MatthieuGrr/alidade_ros2/alidade_description/meshes/camera_adaptor.stl

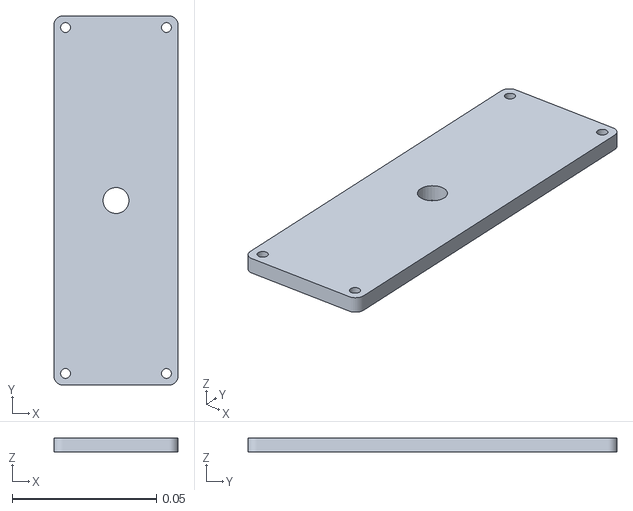
[picture p1: CAD file, 2026-10-08]
alidade_description/meshes/camera_adaptor.stl
0.043 x 0.128 x 0.005
