MatthieuGrr/alidade_ros2/alidade_description/meshes/motor_driver_left_link.stl

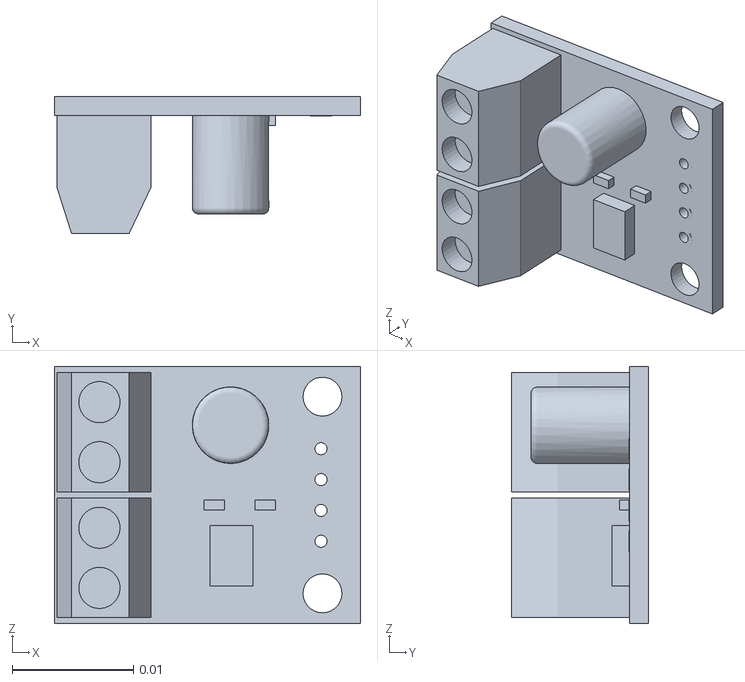
[picture p2: CAD file, 2026-09-28]
alidade_description/meshes/motor_driver_left_link.stl
0.0252 x 0.0113 x 0.0212
