MatthieuGrr/alidade_ros2/alidade_description/meshes/motor_mount_left_link.stl

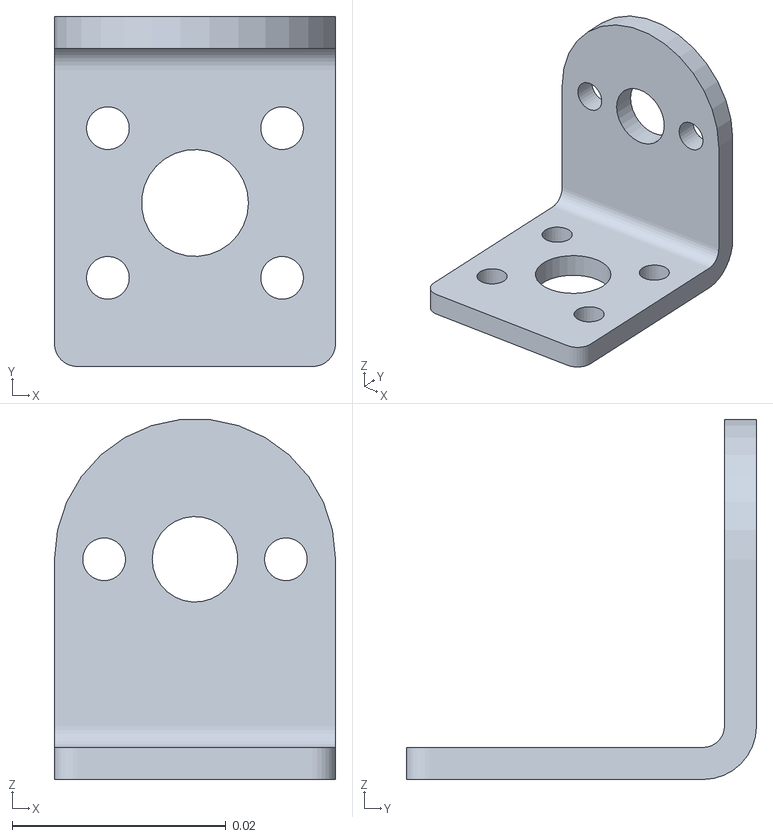
[picture p3: CAD file, 2026-09-28]
alidade_description/meshes/motor_mount_left_link.stl
0.0263 x 0.0327 x 0.0337
