MatthieuGrr/alidade_ros2/alidade_description/meshes/power_bracket_link.stl

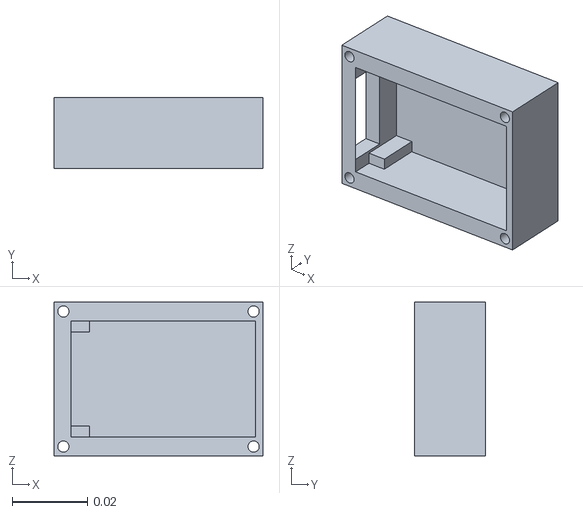
[picture p4: CAD file, 2026-09-28]
alidade_description/meshes/power_bracket_link.stl
0.0557 x 0.019 x 0.041
