MatthieuGrr/alidade_ros2/alidade_description/meshes/wheel_right_link.stl

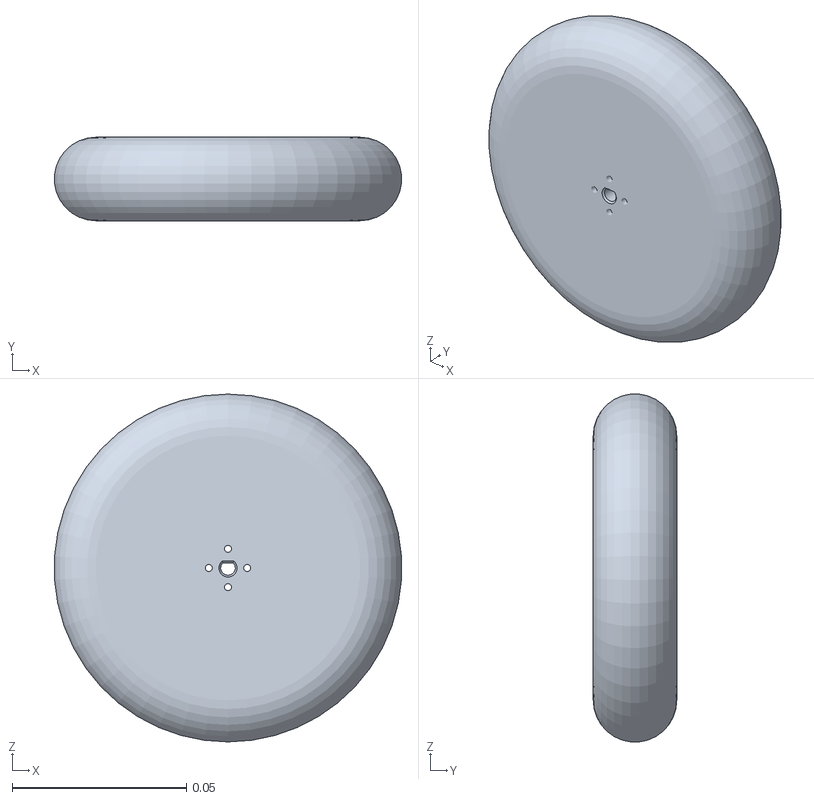
[picture p5: CAD file, 2026-09-28]
alidade_description/meshes/wheel_right_link.stl
0.0996 x 0.024 x 0.0999
