MatthieuGrr/alidade_ros2/alidade_description/meshes/motor_right_link.stl

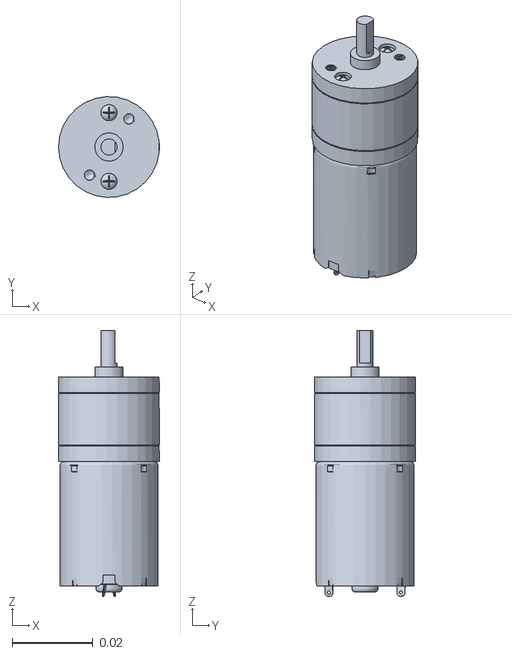
[picture p6: CAD file, 2026-09-28]
alidade_description/meshes/motor_right_link.stl
0.025 x 0.025 x 0.0659
