MatthieuGrr/alidade_ros2/alidade_description/meshes/laser.stl

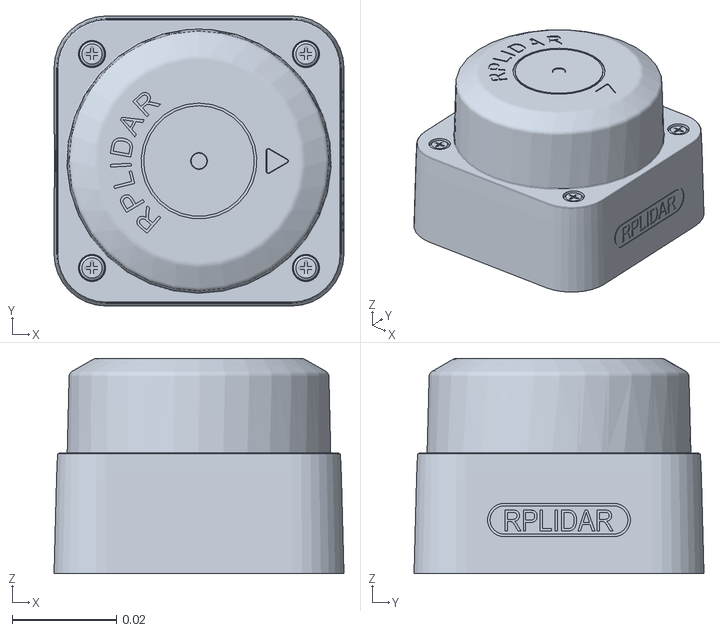
[picture p7: CAD file, 2026-09-28]
alidade_description/meshes/laser.stl
0.0556 x 0.0556 x 0.0413
