MatthieuGrr/alidade_ros2/alidade_description/meshes/base_link.stl

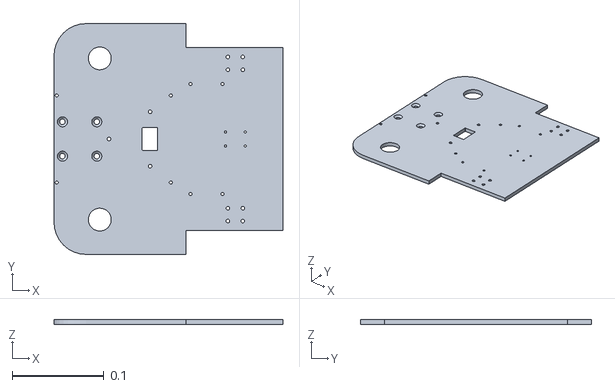
[picture p8: CAD file, 2026-09-28]
alidade_description/meshes/base_link.stl
0.25 x 0.252 x 0.005
