MatthieuGrr/alidade_ros2/alidade_description/meshes/deck_link.stl

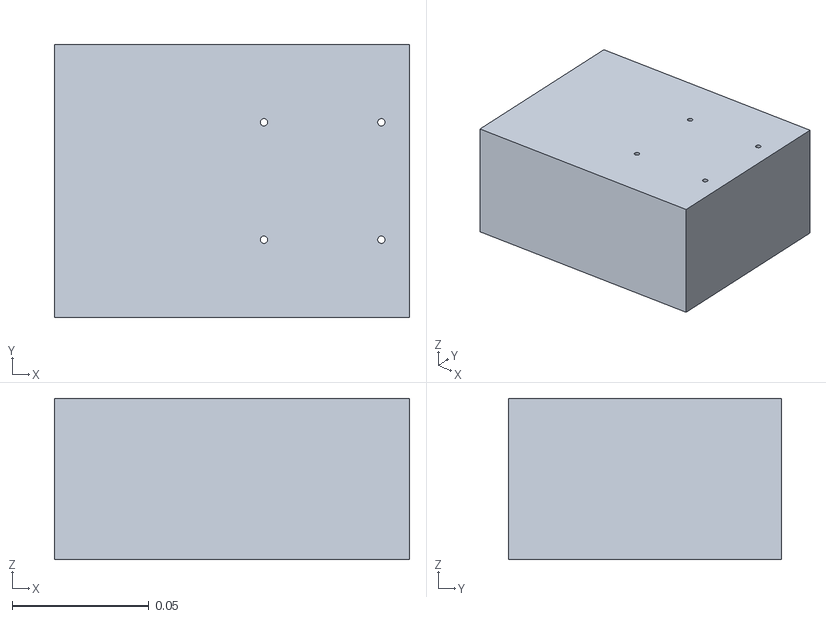
[picture p9: CAD file, 2026-09-28]
alidade_description/meshes/deck_link.stl
0.13 x 0.1 x 0.059
