MatthieuGrr/alidade_ros2/alidade_description/meshes/pi_link.stl

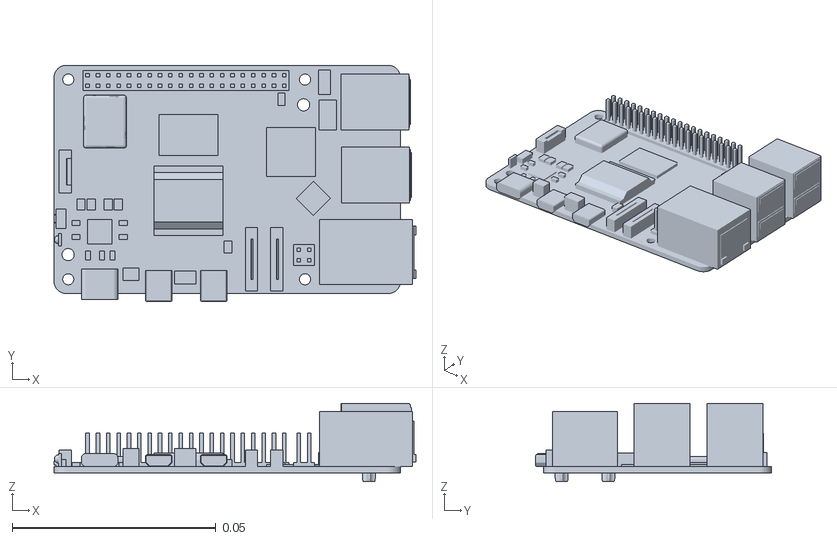
[picture p10: CAD file, 2026-09-28]
alidade_description/meshes/pi_link.stl
0.0888 x 0.058 x 0.0192
