MatthieuGrr/alidade_ros2/alidade_description/meshes/camera_mount_link.stl

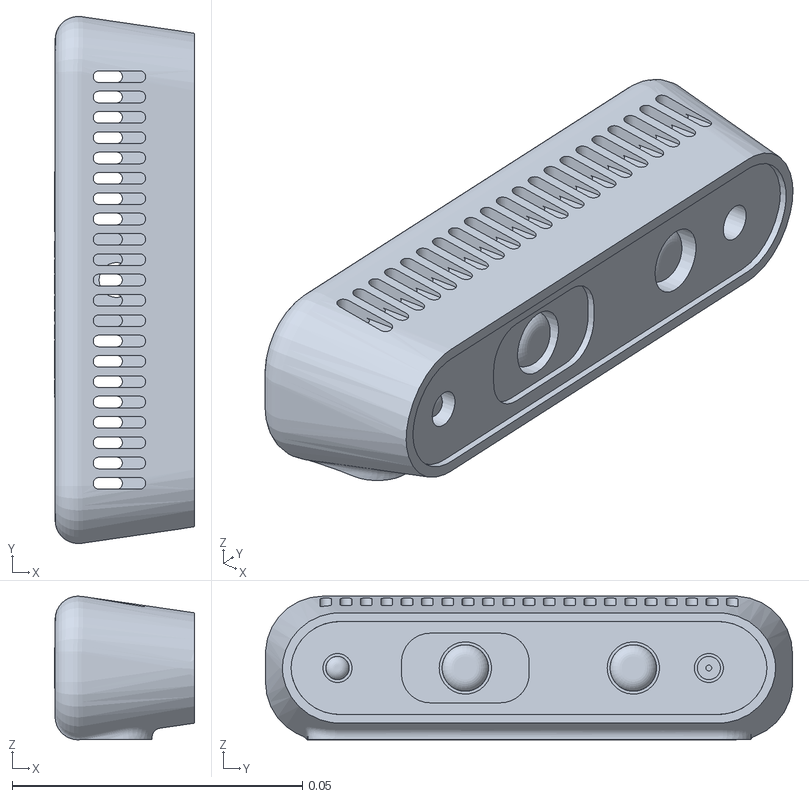
[picture p11: CAD file, 2026-09-28]
alidade_description/meshes/camera_mount_link.stl
0.0241 x 0.0907 x 0.0247
