MatthieuGrr/alidade_ros2/alidade_description/meshes/imu_link.stl

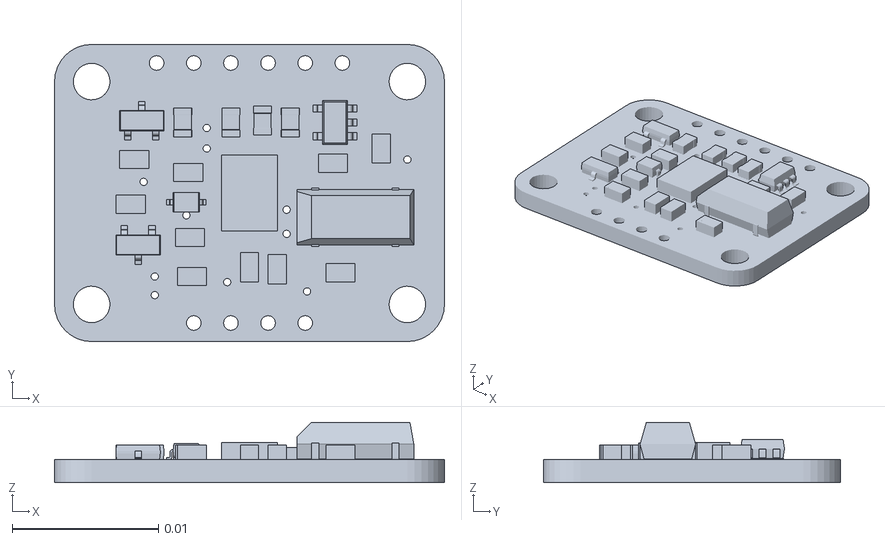
[picture p12: CAD file, 2026-09-28]
alidade_description/meshes/imu_link.stl
0.0267 x 0.0203 x 0.00413
