MatthieuGrr/alidade_ros2/alidade_description/meshes/driver_board_link.stl

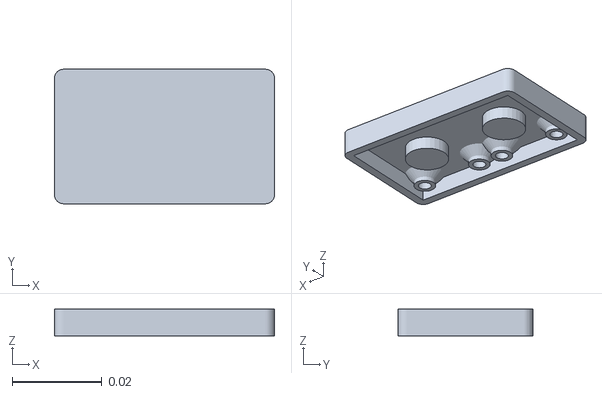
[picture p13: CAD file, 2026-09-28]
alidade_description/meshes/driver_board_link.stl
0.0491 x 0.03 x 0.006
