MatthieuGrr/alidade_ros2/alidade_description/meshes/pi_mount_link.stl

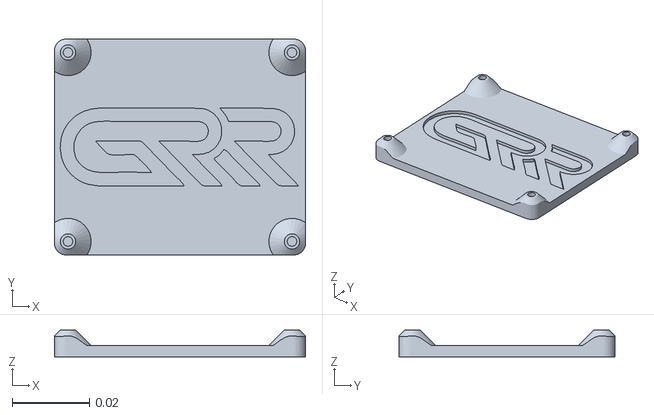
[picture p14: CAD file, 2026-09-28]
alidade_description/meshes/pi_mount_link.stl
0.0651 x 0.056 x 0.007
