MatthieuGrr/alidade_ros2/alidade_description/meshes/battery_tray_link.stl

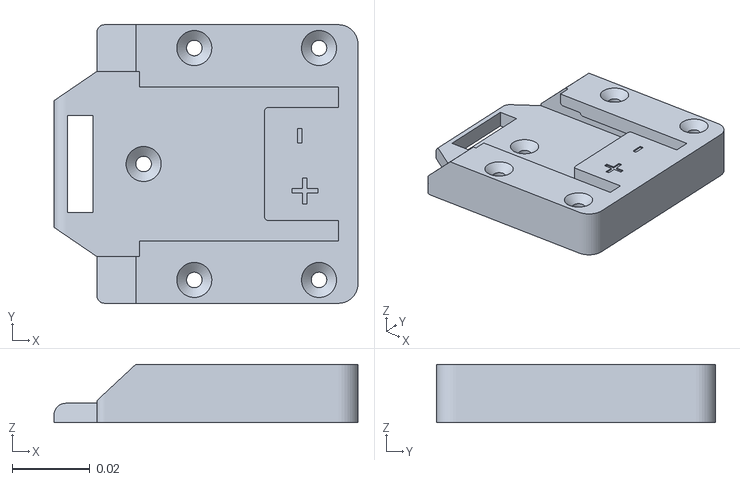
[picture p15: CAD file, 2026-09-28]
alidade_description/meshes/battery_tray_link.stl
0.078 x 0.0715 x 0.015
