MatthieuGrr/alidade_ros2/alidade_description/meshes/caster_wheel_link.stl

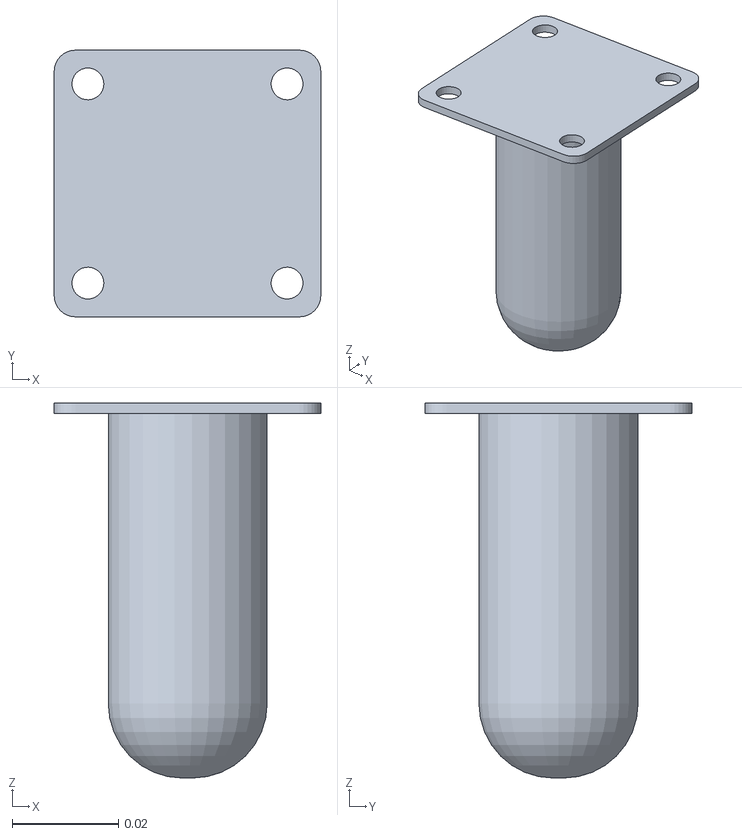
[picture p16: CAD file, 2026-09-28]
alidade_description/meshes/caster_wheel_link.stl
0.0502 x 0.0502 x 0.0706
