MatthieuGrr/alidade_ros2/alidade_description/meshes/dcdc_link.stl

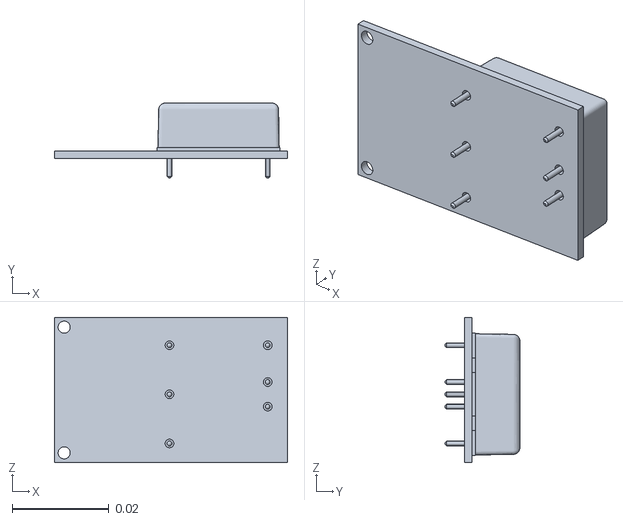
[picture p17: CAD file, 2026-09-28]
alidade_description/meshes/dcdc_link.stl
0.0482 x 0.0155 x 0.03
