MatthieuGrr/alidade_ros2/alidade_description/meshes/battery_link.stl

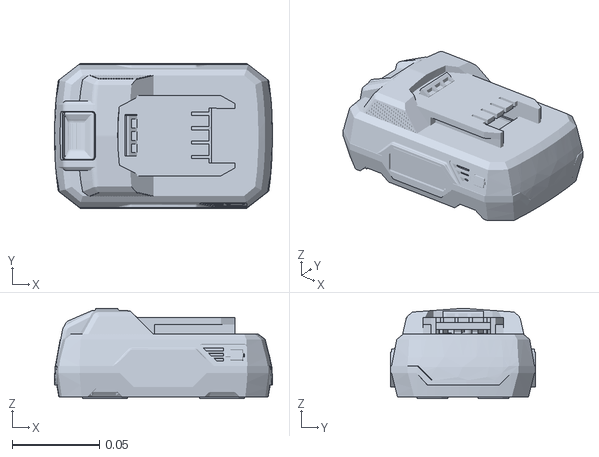
[picture p18: CAD file, 2026-09-28]
alidade_description/meshes/battery_link.stl
0.125 x 0.0828 x 0.0518
