MatthieuGrr/alidade_ros2/(list of files, cad)

Other CAD files:
alidade_description/meshes/motor_driver_right_link.stl
alidade_description/meshes/wheel_left_link.stl
alidade_description/meshes/motor_mount_right_link.stl
alidade_description/meshes/motor_left_link.stl
