MatthieuGrr/alidade_ros2/alidade_description/urdf/onshape/alidade_v2.urdf

<!--URDF generated by ONSHAPE BY PTC INC, 1.221-->
<robot name="alidade_v2">
    <link name="base_link">
        <inertial>
            <mass value="0.000275747" />
            <origin xyz="-0.129402 5.40301e-18 0.00249813" rpy="0 -0 0" />
            <inertia ixx="1.23398e-06" ixy="0" ixz="-4.77266e-11" iyy="1.3884e-06" iyz="0" izz="2.62123e-06" />
        </inertial>
        <visual>
            <origin xyz="-0.125 6.93889e-18 0" rpy="0 -0 0" />
            <geometry>
                <mesh filename="package://alidade_v2/meshes/base_link.stl" scale="1 1 1" />
            </geometry>
            <material name="0.615686_0.811765_0.929412_0.000000_0.000000">
                <color rgba="0.615686 0.811765 0.929412 1" />
            </material>
        </visual>
    </link>
    <link name="battery_link">
        <inertial>
            <mass value="0.000122132" />
            <origin xyz="-0.00630539 0.000320142 -0.0239702" rpy="0 -0 0" />
            <inertia ixx="1.07262e-07" ixy="-8.34136e-10" ixz="6.80454e-09" iyy="1.97665e-07" iyz="-8.1505e-10" izz="2.44575e-07" />
        </inertial>
        <visual>
            <origin xyz="0.120887 -0.125114 -0.04564" rpy="0 -0 0" />
            <geometry>
                <mesh filename="package://alidade_v2/meshes/battery_link.stl" scale="1 1 1" />
            </geometry>
            <material name="0.262745_0.282353_0.301961_0.000000_0.000000">
                <color rgba="0.262745 0.282353 0.301961 1" />
            </material>
        </visual>
    </link>
    <link name="battery_tray_link">
        <inertial>
            <mass value="4.3209e-05" />
            <origin xyz="-0.0138058 5.80321e-07 0.00617586" rpy="0 -0 0" />
            <inertia ixx="2.51517e-08" ixy="-4.83523e-13" ixz="-1.02772e-09" iyy="1.80906e-08" iyz="-2.13115e-13" izz="4.14968e-08" />
        </inertial>
        <visual>
            <origin xyz="-0.148 -0.128 0" rpy="0 -0 0" />
            <geometry>
                <mesh filename="package://alidade_v2/meshes/battery_tray_link.stl" scale="1 1 1" />
            </geometry>
            <material name="0.000000_1.000000_0.000000_0.000000_0.000000">
                <color rgba="0 1 0 1" />
            </material>
        </visual>
    </link>
    <link name="camera_adaptor">
        <inertial>
            <mass value="2.69817e-05" />
            <origin xyz="0.0175 -0.06 0.0025" rpy="0 -0 0" />
            <inertia ixx="3.68198e-08" ixy="0" ixz="0" iyy="4.22246e-09" iyz="0" izz="4.09298e-08" />
        </inertial>
        <visual>
            <origin xyz="0.0175 -0.06 0" rpy="0 -0 0" />
            <geometry>
                <mesh filename="package://alidade_v2/meshes/camera_adaptor.stl" scale="1 1 1" />
            </geometry>
            <material name="0.615686_0.811765_0.929412_0.000000_0.000000">
                <color rgba="0.615686 0.811765 0.929412 1" />
            </material>
        </visual>
    </link>
    <link name="camera_mount_link">
        <inertial>
            <mass value="3.8641e-05" />
            <origin xyz="0.000591792 1.14347e-05 0.0121337" rpy="0 -0 0" />
            <inertia ixx="2.57349e-08" ixy="-8.20526e-12" ixz="9.94182e-12" iyy="3.37328e-09" iyz="-7.10456e-14" izz="2.59396e-08" />
        </inertial>
        <visual>
            <origin xyz="-0.0189515 1.10602e-18 0.0039" rpy="0 -0 0" />
            <geometry>
                <mesh filename="package://alidade_v2/meshes/camera_mount_link.stl" scale="1 1 1" />
            </geometry>
            <material name="0.866667_0.909804_1.000000_0.000000_0.000000">
                <color rgba="0.866667 0.909804 1 1" />
            </material>
        </visual>
    </link>
    <link name="caster_wheel_link">
        <inertial>
            <mass value="5.01392e-05" />
            <origin xyz="0.01875 -0.01875 -0.0310007" rpy="0 -0 0" />
            <inertia ixx="2.40072e-08" ixy="0" ixz="0" iyy="2.40072e-08" iyz="0" izz="6.87745e-09" />
        </inertial>
        <visual>
            <origin xyz="0.01875 -0.01875 0" rpy="0 -0 0" />
            <geometry>
                <mesh filename="package://alidade_v2/meshes/caster_wheel_link.stl" scale="1 1 1" />
            </geometry>
            <material name="0.615686_0.811765_0.929412_0.000000_0.000000">
                <color rgba="0.615686 0.811765 0.929412 1" />
            </material>
        </visual>
    </link>
    <link name="dcdc_link">
        <inertial>
            <mass value="8.34806e-06" />
            <origin xyz="0.0313637 0.00337726 0.0143404" rpy="0 -0 0" />
            <inertia ixx="5.85964e-10" ixy="-8.96499e-11" ixz="1.42058e-11" iyy="1.37803e-09" iyz="8.4184e-12" izz="9.98118e-10" />
        </inertial>
        <visual>
            <origin xyz="0.03395 0.0007 0.0141" rpy="0 -0 0" />
            <geometry>
                <mesh filename="package://alidade_v2/meshes/dcdc_link.stl" scale="1 1 1" />
            </geometry>
            <material name="0.000000_0.000000_0.000000_0.000000_0.000000">
                <color rgba="0 0 0 1" />
            </material>
        </visual>
    </link>
    <link name="deck_link">
        <inertial>
            <mass value="0.00014731" />
            <origin xyz="-0.0520213 -0.0475 0.037967" rpy="0 -0 0" />
            <inertia ixx="2.72724e-07" ixy="0" ixz="1.62442e-08" iyy="3.04225e-07" iyz="0" izz="4.70608e-07" />
        </inertial>
        <visual>
            <origin xyz="-0.0025 -0.0475 -0.005" rpy="0 -0 0" />
            <geometry>
                <mesh filename="package://alidade_v2/meshes/deck_link.stl" scale="1 1 1" />
            </geometry>
            <material name="0.647059_0.647059_0.647059_0.000000_0.000000">
                <color rgba="0.647059 0.647059 0.647059 1" />
            </material>
        </visual>
    </link>
    <link name="driver_board_link">
        <inertial>
            <mass value="4.89491e-06" />
            <origin xyz="8.10699e-11 -0.000565178 -0.00209501" rpy="0 -0 0" />
            <inertia ixx="4.35323e-10" ixy="0" ixz="0" iyy="1.09988e-09" iyz="-2.76617e-12" izz="1.51086e-09" />
        </inertial>
        <visual>
            <origin xyz="-0.01127 1.15247e-18 0.00075" rpy="0 -0 0" />
            <geometry>
                <mesh filename="package://alidade_v2/meshes/driver_board_link.stl" scale="1 1 1" />
            </geometry>
            <material name="0.768627_0.886275_0.952941_0.000000_0.000000">
                <color rgba="0.768627 0.886275 0.952941 1" />
            </material>
        </visual>
    </link>
    <link name="imu_link">
        <inertial>
            <mass value="9.34871e-07" />
            <origin xyz="0.00236646 -0.00269805 -0.000534892" rpy="0 -0 0" />
            <inertia ixx="2.7347e-11" ixy="6.31926e-13" ixz="-8.2028e-13" iyy="5.10439e-11" iyz="1.55278e-13" izz="7.72887e-11" />
        </inertial>
        <visual>
            <origin xyz="0.010155 0.00248 -0.00157" rpy="0 -0 0" />
            <geometry>
                <mesh filename="package://alidade_v2/meshes/imu_link.stl" scale="1 1 1" />
            </geometry>
            <material name="1.000000_1.000000_1.000000_0.000000_0.000000">
                <color rgba="1 1 1 1" />
            </material>
        </visual>
    </link>
    <link name="laser">
        <inertial>
            <mass value="3.23157e-05" />
            <origin xyz="8.41462e-05 -9.44507e-05 -0.0165779" rpy="0 -0 0" />
            <inertia ixx="1.41413e-08" ixy="-2.23006e-12" ixz="2.21212e-11" iyy="1.40971e-08" iyz="-1.67404e-11" izz="1.99332e-08" />
        </inertial>
        <visual>
            <origin xyz="-2.3726e-19 -4.2615e-17 -0.0305964" rpy="0 -0 0" />
            <geometry>
                <mesh filename="package://alidade_v2/meshes/laser.stl" scale="1 1 1" />
            </geometry>
            <material name="0.156863_0.156863_0.156863_0.000000_0.000000">
                <color rgba="0.156863 0.156863 0.156863 1" />
            </material>
        </visual>
    </link>
    <link name="motor_driver_left_link">
        <inertial>
            <mass value="1.87625e-06" />
            <origin xyz="-0.0127238 -0.00396475 0.00880106" rpy="0 -0 0" />
            <inertia ixx="8.87806e-11" ixy="-1.70994e-11" ixz="-6.76803e-12" iyy="1.44367e-10" iyz="2.57579e-12" izz="1.00757e-10" />
        </inertial>
        <visual>
            <origin xyz="-0.06707 0 0.0005" rpy="0 -0 0" />
            <geometry>
                <mesh filename="package://alidade_v2/meshes/motor_driver_left_link.stl" scale="1 1 1" />
            </geometry>
            <material name="0.768627_0.886275_0.952941_0.000000_0.000000">
                <color rgba="0.768627 0.886275 0.952941 1" />
            </material>
        </visual>
    </link>
    <link name="motor_driver_right_link">
        <inertial>
            <mass value="1.87625e-06" />
            <origin xyz="-0.0127238 -0.00396475 -0.00739894" rpy="0 -0 0" />
            <inertia ixx="8.87806e-11" ixy="-1.70994e-11" ixz="-6.76803e-12" iyy="1.44367e-10" iyz="2.57579e-12" izz="1.00757e-10" />
        </inertial>
        <visual>
            <origin xyz="-0.06707 0 -0.0497" rpy="0 -0 0" />
            <geometry>
                <mesh filename="package://alidade_v2/meshes/motor_driver_right_link.stl" scale="1 1 1" />
            </geometry>
            <material name="0.768627_0.886275_0.952941_0.000000_0.000000">
                <color rgba="0.768627 0.886275 0.952941 1" />
            </material>
        </visual>
    </link>
    <link name="motor_left_link">
        <inertial>
            <mass value="2.4232e-05" />
            <origin xyz="3.52782e-06 1.18369e-06 -0.0247986" rpy="0 -0 0" />
            <inertia ixx="6.23821e-09" ixy="1.51175e-12" ixz="4.03364e-13" iyy="6.23998e-09" iyz="7.15374e-13" izz="1.84251e-09" />
        </inertial>
        <visual>
            <origin xyz="4.03494e-06 4.21546e-08 -0.021" rpy="0 -0 0" />
            <geometry>
                <mesh filename="package://alidade_v2/meshes/motor_left_link.stl" scale="1 1 1" />
            </geometry>
            <material name="0.800000_0.800000_0.800000_0.000000_0.000000">
                <color rgba="0.8 0.8 0.8 1" />
            </material>
        </visual>
    </link>
    <link name="motor_mount_left_link">
        <inertial>
            <mass value="4.05041e-06" />
            <origin xyz="0.00815 0.0010031 0.00895425" rpy="0 -0 0" />
            <inertia ixx="8.18103e-10" ixy="0" ixz="0" iyy="6.21383e-10" iyz="-2.39803e-10" izz="6.74037e-10" />
        </inertial>
        <visual>
            <origin xyz="0.00815 -0.0223 0" rpy="0 -0 0" />
            <geometry>
                <mesh filename="package://alidade_v2/meshes/motor_mount_left_link.stl" scale="1 1 1" />
            </geometry>
            <material name="0.262745_0.282353_0.301961_0.000000_0.000000">
                <color rgba="0.262745 0.282353 0.301961 1" />
            </material>
        </visual>
    </link>
    <link name="motor_mount_right_link">
        <inertial>
            <mass value="4.05041e-06" />
            <origin xyz="-0.00815 0.0010031 0.00895425" rpy="0 -0 0" />
            <inertia ixx="8.18103e-10" ixy="0" ixz="0" iyy="6.21383e-10" iyz="-2.39803e-10" izz="6.74037e-10" />
        </inertial>
        <visual>
            <origin xyz="-0.00815 -0.0223 0" rpy="0 -0 0" />
            <geometry>
                <mesh filename="package://alidade_v2/meshes/motor_mount_right_link.stl" scale="1 1 1" />
            </geometry>
            <material name="0.262745_0.282353_0.301961_0.000000_0.000000">
                <color rgba="0.262745 0.282353 0.301961 1" />
            </material>
        </visual>
    </link>
    <link name="motor_right_link">
        <inertial>
            <mass value="2.4232e-05" />
            <origin xyz="-5.07116e-07 1.14154e-06 -0.0247986" rpy="0 -0 0" />
            <inertia ixx="6.23821e-09" ixy="1.51175e-12" ixz="4.03361e-13" iyy="6.23998e-09" iyz="7.15371e-13" izz="1.84251e-09" />
        </inertial>
        <visual>
            <origin xyz="0 -0.0338 -0.021" rpy="0 -0 0" />
            <geometry>
                <mesh filename="package://alidade_v2/meshes/motor_right_link.stl" scale="1 1 1" />
            </geometry>
            <material name="0.800000_0.800000_0.800000_0.000000_0.000000">
                <color rgba="0.8 0.8 0.8 1" />
            </material>
        </visual>
    </link>
    <link name="pi_link">
        <inertial>
            <mass value="2.29908e-05" />
            <origin xyz="0.0563352 0.0234255 0.00545939" rpy="0 -0 0" />
            <inertia ixx="6.64877e-09" ixy="-4.90206e-11" ixz="-1.58651e-09" iyy="1.52185e-08" iyz="-4.52681e-11" izz="2.07467e-08" />
        </inertial>
        <visual>
            <origin xyz="0.039 0.0245 0" rpy="0 -0 0" />
            <geometry>
                <mesh filename="package://alidade_v2/meshes/pi_link.stl" scale="1 1 1" />
            </geometry>
            <material name="0.862745_0.862745_0.862745_0.000000_0.000000">
                <color rgba="0.862745 0.862745 0.862745 1" />
            </material>
        </visual>
    </link>
    <link name="pi_mount_link">
        <inertial>
            <mass value="1.09201e-05" />
            <origin xyz="-5.9353e-06 2.73651e-06 0.0016171" rpy="0 -0 0" />
            <inertia ixx="3.20565e-09" ixy="1.89968e-12" ixz="5.66429e-14" iyy="4.19035e-09" iyz="-2.74213e-14" izz="7.36865e-09" />
        </inertial>
        <visual>
            <origin xyz="0.00995724 6.36564e-19 0.007" rpy="0 -0 0" />
            <geometry>
                <mesh filename="package://alidade_v2/meshes/pi_mount_link.stl" scale="1 1 1" />
            </geometry>
            <material name="0.980392_0.713725_0.003922_0.000000_0.000000">
                <color rgba="0.980392 0.713726 0.00392157 1" />
            </material>
        </visual>
    </link>
    <link name="power_bracket_link">
        <inertial>
            <mass value="1.64647e-05" />
            <origin xyz="-0.00111389 -0.00773123 -1.02036e-05" rpy="0 -0 0" />
            <inertia ixx="4.44442e-09" ixy="2.07263e-11" ixz="-4.07847e-12" iyy="9.06578e-09" iyz="-8.83554e-13" izz="5.78195e-09" />
        </inertial>
        <visual>
            <origin xyz="0.0111 -0.01275 -0.0009" rpy="0 -0 0" />
            <geometry>
                <mesh filename="package://alidade_v2/meshes/power_bracket_link.stl" scale="1 1 1" />
            </geometry>
            <material name="0.972549_0.529412_0.003922_0.000000_0.000000">
                <color rgba="0.972549 0.529412 0.00392157 1" />
            </material>
        </visual>
    </link>
    <link name="root" />
    <link name="wheel_left_link">
        <inertial>
            <mass value="0.000167891" />
            <origin xyz="-3.93855e-07 -7.06244e-06 -4.21881e-08" rpy="0 1.46409 0" />
            <inertia ixx="1.04351e-07" ixy="0" ixz="-7.87631e-15" iyy="1.94048e-07" iyz="0" izz="1.04351e-07" />
        </inertial>
        <visual>
            <origin xyz="-6.84862e-07 -0.055 -7.33596e-08" rpy="0 1.46409 0" />
            <geometry>
                <mesh filename="package://alidade_v2/meshes/wheel_left_link.stl" scale="1 1 1" />
            </geometry>
            <material name="0.262745_0.282353_0.301961_0.000000_0.000000">
                <color rgba="0.262745 0.282353 0.301961 1" />
            </material>
        </visual>
    </link>
    <link name="wheel_right_link">
        <inertial>
            <mass value="0.000167891" />
            <origin xyz="1.99535e-20 -7.06244e-06 -3.86019e-07" rpy="0 -0 0" />
            <inertia ixx="1.04351e-07" ixy="0" ixz="0" iyy="1.94048e-07" iyz="0" izz="1.04351e-07" />
        </inertial>
        <visual>
            <origin xyz="-1.17538e-20 -0.012 -6.78691e-07" rpy="0 -0 0" />
            <geometry>
                <mesh filename="package://alidade_v2/meshes/wheel_right_link.stl" scale="1 1 1" />
            </geometry>
            <material name="0.262745_0.282353_0.301961_0.000000_0.000000">
                <color rgba="0.262745 0.282353 0.301961 1" />
            </material>
        </visual>
    </link>
    <joint name="base_joint" type="fixed">
        <origin xyz="0.052 0 0.070601" rpy="-7.99361e-15 5.45793e-29 3.9968e-15" />
        <axis xyz="0 0 1" />
        <parent link="root" />
        <child link="base_link" />
    </joint>
    <joint name="battery_joint" type="fixed">
        <origin xyz="-0.0306365 5.51219e-11 0.005" rpy="-3.14159 -2.1684e-19 -3.21271e-15" />
        <axis xyz="-2.1684e-19 -1.38778e-17 1" />
        <parent link="battery_tray_link" />
        <child link="battery_link" />
    </joint>
    <joint name="battery_tray_joint" type="fixed">
        <origin xyz="-0.153984 -2.41044e-18 0.005" rpy="2.66454e-15 -2.55579e-29 -3.9968e-15" />
        <axis xyz="0 0 -1" />
        <parent link="base_link" />
        <child link="battery_tray_link" />
    </joint>
    <joint name="camera_adaptor_joint" type="fixed">
        <origin xyz="-0.066 -0.06 0.065" rpy="-7.99361e-15 2.66454e-15 3.14159" />
        <axis xyz="0 0 1" />
        <parent link="base_link" />
        <child link="camera_adaptor" />
    </joint>
    <joint name="camera_mount_joint" type="fixed">
        <origin xyz="0.0175 -0.06 0.005" rpy="1.45363e-17 6.12323e-17 -3.14159" />
        <axis xyz="-6.12323e-17 1.45363e-17 1" />
        <parent link="camera_adaptor" />
        <child link="camera_mount_link" />
    </joint>
    <joint name="caster_wheel_joint" type="fixed">
        <origin xyz="-0.24075 0.01875 0" rpy="5.32907e-15 -3.06177e-29 -3.9968e-15" />
        <axis xyz="-0 -0 1" />
        <parent link="base_link" />
        <child link="caster_wheel_link" />
    </joint>
    <joint name="dcdc_joint" type="fixed">
        <origin xyz="-0.02335 -0.01345 -0.0155" rpy="5.55112e-17 -5.55112e-17 5.55112e-17" />
        <axis xyz="0 1 0" />
        <parent link="power_bracket_link" />
        <child link="dcdc_link" />
    </joint>
    <joint name="deck_joint" type="fixed">
        <origin xyz="-0.1225 0.0475 0.005" rpy="1.97215e-31 -3.06177e-29 -3.9968e-15" />
        <axis xyz="0 0 1" />
        <parent link="base_link" />
        <child link="deck_link" />
    </joint>
    <joint name="driver_board_joint" type="fixed">
        <origin xyz="-0.111954 -5.15443e-18 0" rpy="-7.99361e-15 7.99361e-15 1.5708" />
        <axis xyz="0 0 1" />
        <parent link="base_link" />
        <child link="driver_board_link" />
    </joint>
    <joint name="imu_joint" type="fixed">
        <origin xyz="-0.0539 -0.0026 -0.00457" rpy="-3.14159 -6.25665e-29 -3.9968e-15" />
        <axis xyz="0 0 1" />
        <parent link="base_link" />
        <child link="imu_link" />
    </joint>
    <joint name="laser_joint" type="fixed">
        <origin xyz="-0.0293 -0.0475 0.0985963" rpy="1.40166e-15 -1.38778e-17 -9.72595e-33" />
        <axis xyz="1.38778e-17 1.40166e-15 1" />
        <parent link="deck_link" />
        <child link="laser" />
    </joint>
    <joint name="motor_driver_left_joint" type="fixed">
        <origin xyz="0.01924 -0.00941 -0.005" rpy="1.5708 -0 -1.5708" />
        <axis xyz="0 1 0" />
        <parent link="driver_board_link" />
        <child link="motor_driver_left_link" />
    </joint>
    <joint name="motor_driver_right_joint" type="fixed">
        <origin xyz="-0.01924 -0.00941 -0.005" rpy="1.5708 -0 -1.5708" />
        <axis xyz="0 1 0" />
        <parent link="driver_board_link" />
        <child link="motor_driver_right_link" />
    </joint>
    <joint name="motor_left_joint" type="fixed">
        <origin xyz="0.00815 0.00745 0.0206" rpy="1.5708 -1.19349e-15 3.14159" />
        <axis xyz="0 0 1" />
        <parent link="motor_mount_left_link" />
        <child link="motor_left_link" />
    </joint>
    <joint name="motor_mount_left_joint" type="fixed">
        <origin xyz="-0.04385 0.08955 9.71445e-16" rpy="3.14159 -7.79529e-28 3.14159" />
        <axis xyz="0 0 -1" />
        <parent link="base_link" />
        <child link="motor_mount_left_link" />
    </joint>
    <joint name="motor_mount_right_joint" type="fixed">
        <origin xyz="-0.04385 -0.08955 -9.4369e-16" rpy="-3.14159 -3.19073e-29 -4.7462e-15" />
        <axis xyz="-0 -0 -1" />
        <parent link="base_link" />
        <child link="motor_mount_right_link" />
    </joint>
    <joint name="motor_right_joint" type="fixed">
        <origin xyz="-0.00815 0.00745 0.0206" rpy="-1.5708 -2.498e-16 3.81718e-16" />
        <axis xyz="0 0 1" />
        <parent link="motor_mount_right_link" />
        <child link="motor_right_link" />
    </joint>
    <joint name="pi_joint" type="fixed">
        <origin xyz="-0.0290428 -0.0245 0.007" rpy="-7.81319e-15 1.9984e-15 -1.249e-16" />
        <axis xyz="-0 -0 -1" />
        <parent link="pi_mount_link" />
        <child link="pi_link" />
    </joint>
    <joint name="pi_mount_joint" type="fixed">
        <origin xyz="-0.0875 0.0025 0.0295" rpy="-1.5708 9.86076e-31 -1.77494e-30" />
        <axis xyz="0 0 -1" />
        <parent link="deck_link" />
        <child link="pi_mount_link" />
    </joint>
    <joint name="power_bracket_joint" type="fixed">
        <origin xyz="-0.136954 0.08 0" rpy="1.5708 1.40443e-14 1.5708" />
        <axis xyz="0 1 0" />
        <parent link="base_link" />
        <child link="power_bracket_link" />
    </joint>
    <joint name="wheel_left_joint" type="continuous">
        <origin xyz="4.03494e-06 4.21546e-08 0.0155" rpy="1.5708 3.33067e-16 6.245e-16" />
        <axis xyz="0 1 0" />
        <parent link="motor_left_link" />
        <child link="wheel_left_link" />
    </joint>
    <joint name="wheel_right_joint" type="continuous">
        <origin xyz="1.00466e-20 6.93889e-18 0.0155" rpy="-1.5708 -5.27356e-16 8.32667e-17" />
        <axis xyz="0 1 0" />
        <parent link="motor_right_link" />
        <child link="wheel_right_link" />
    </joint>
</robot>
