MatthieuGrr/alidade_ros2/alidade_description/urdf/onshape/alidade.urdf

<!--URDF generated by ONSHAPE BY PTC INC, 1.220-->
<robot name="main_assembly">
    <link name="base_link">
        <inertial>
            <mass value="0.000109733" />
            <origin xyz="0.0788109 -9.54098e-18 0.00249915" rpy="0 -0 0" />
            <inertia ixx="2.04961e-07" ixy="0" ixz="5.25673e-12" iyy="2.09795e-07" iyz="0" izz="4.14299e-07" />
        </inertial>
        <visual>
            <origin xyz="0.0357727 0.00237726 0" rpy="0 -0 0" />
            <geometry>
                <mesh filename="package://main_assembly/meshes/base_link.stl" scale="1 1 1" />
            </geometry>
            <material name="0.615686_0.811765_0.929412_0.000000_0.000000">
                <color rgba="0.615686 0.811765 0.929412 1" />
            </material>
        </visual>
    </link>
    <link name="battery_link">
        <inertial>
            <mass value="0.000122132" />
            <origin xyz="-0.00630538 0.000320142 -0.0239702" rpy="0 -0 0" />
            <inertia ixx="1.07262e-07" ixy="-8.34039e-10" ixz="6.80454e-09" iyy="1.97665e-07" iyz="-8.15054e-10" izz="2.44575e-07" />
        </inertial>
        <visual>
            <origin xyz="0.120887 -0.125114 -0.04564" rpy="0 -0 0" />
            <geometry>
                <mesh filename="package://main_assembly/meshes/battery_link.stl" scale="1 1 1" />
            </geometry>
            <material name="0.262745_0.282353_0.301961_0.000000_0.000000">
                <color rgba="0.262745 0.282353 0.301961 1" />
            </material>
        </visual>
    </link>
    <link name="battery_tray_link">
        <inertial>
            <mass value="4.3209e-05" />
            <origin xyz="-0.0138058 5.80321e-07 0.00617586" rpy="0 -0 0" />
            <inertia ixx="2.51517e-08" ixy="-4.83523e-13" ixz="-1.02772e-09" iyy="1.80906e-08" iyz="-2.13115e-13" izz="4.14968e-08" />
        </inertial>
        <visual>
            <origin xyz="-0.148 -0.128 0" rpy="0 -0 0" />
            <geometry>
                <mesh filename="package://main_assembly/meshes/battery_tray_link.stl" scale="1 1 1" />
            </geometry>
            <material name="0.000000_1.000000_0.000000_0.000000_0.000000">
                <color rgba="0 1 0 1" />
            </material>
        </visual>
    </link>
    <link name="camera_link">
        <inertial>
            <mass value="4.24237e-05" />
            <origin xyz="0.0101277 -2.34651e-06 -0.0136735" rpy="0 -0 0" />
            <inertia ixx="2.32439e-08" ixy="-1.03565e-12" ixz="5.58062e-11" iyy="4.49318e-09" iyz="-7.45328e-13" izz="2.20983e-08" />
        </inertial>
        <visual>
            <origin xyz="0.0208 0 -0.015" rpy="0 -0 0" />
            <geometry>
                <mesh filename="package://main_assembly/meshes/camera_link.stl" scale="1 1 1" />
            </geometry>
            <material name="0.298039_0.298039_0.298039_0.000000_0.000000">
                <color rgba="0.298039 0.298039 0.298039 1" />
            </material>
        </visual>
    </link>
    <link name="camera_mount_link">
        <inertial>
            <mass value="1.31479e-05" />
            <origin xyz="0.00962728 -0.015 0.00562272" rpy="0 -0 0" />
            <inertia ixx="2.92242e-09" ixy="0" ixz="-6.27574e-10" iyy="2.73154e-09" iyz="0" izz="5.23231e-09" />
        </inertial>
        <visual>
            <origin xyz="0.0358907 -0.015 -0.00757715" rpy="0 -0 0" />
            <geometry>
                <mesh filename="package://main_assembly/meshes/camera_mount_link.stl" scale="1 1 1" />
            </geometry>
            <material name="0.980392_0.713725_0.003922_0.000000_0.000000">
                <color rgba="0.980392 0.713726 0.00392157 1" />
            </material>
        </visual>
    </link>
    <link name="camera_optical_frame">
        <inertial>
            <mass value="1e-09" />
            <origin xyz="0 0 0" rpy="0 -0 0" />
            <inertia ixx="4e-14" ixy="0" ixz="0" iyy="4e-14" iyz="0" izz="4e-14" />
        </inertial>
    </link>
    <link name="caster_fork_link">
        <inertial>
            <mass value="2.36483e-06" />
            <origin xyz="8.75204e-19 1.24439e-18 -0.00678443" rpy="0 -0 0" />
            <inertia ixx="1.33396e-10" ixy="0" ixz="0" iyy="2.96999e-10" iyz="0" izz="3.47994e-10" />
        </inertial>
        <visual>
            <origin xyz="7.00312e-19 0 -0.013" rpy="0 -0 0" />
            <geometry>
                <mesh filename="package://main_assembly/meshes/caster_fork_link.stl" scale="1 1 1" />
            </geometry>
            <material name="0.917647_0.917647_0.917647_0.000000_0.000000">
                <color rgba="0.917647 0.917647 0.917647 1" />
            </material>
        </visual>
    </link>
    <link name="caster_mount_link">
        <inertial>
            <mass value="6.64715e-05" />
            <origin xyz="0.023 7.11059e-18 0.0227469" rpy="0 -0 0" />
            <inertia ixx="2.94302e-08" ixy="0" ixz="0" iyy="2.31205e-08" iyz="0" izz="2.91583e-08" />
        </inertial>
        <visual>
            <origin xyz="0.023 1.73472e-18 0.029" rpy="0 -0 0" />
            <geometry>
                <mesh filename="package://main_assembly/meshes/caster_mount_link.stl" scale="1 1 1" />
            </geometry>
            <material name="0.768627_0.886275_0.952941_0.000000_0.000000">
                <color rgba="0.768627 0.886275 0.952941 1" />
            </material>
        </visual>
    </link>
    <link name="caster_wheel_link">
        <inertial>
            <mass value="5.57528e-06" />
            <origin xyz="2.52583e-19 0 -3.46945e-18" rpy="0 -0 0" />
            <inertia ixx="2.69844e-10" ixy="0" ixz="0" iyy="2.69844e-10" iyz="0" izz="2.69844e-10" />
        </inertial>
        <visual>
            <origin xyz="6.73556e-19 0 -0.013" rpy="0 -0 0" />
            <geometry>
                <mesh filename="package://main_assembly/meshes/caster_wheel_link.stl" scale="1 1 1" />
            </geometry>
            <material name="0.231373_0.380392_0.705882_0.000000_0.000000">
                <color rgba="0.231373 0.380392 0.705882 1" />
            </material>
        </visual>
    </link>
    <link name="dcdc_link">
        <inertial>
            <mass value="8.34806e-06" />
            <origin xyz="0.0313637 0.00337726 0.0143404" rpy="0 -0 0" />
            <inertia ixx="5.85964e-10" ixy="-8.96499e-11" ixz="1.42058e-11" iyy="1.37803e-09" iyz="8.4184e-12" izz="9.98118e-10" />
        </inertial>
        <visual>
            <origin xyz="0.03395 0.0007 0.0141" rpy="0 -0 0" />
            <geometry>
                <mesh filename="package://main_assembly/meshes/dcdc_link.stl" scale="1 1 1" />
            </geometry>
            <material name="0.000000_0.000000_0.000000_0.000000_0.000000">
                <color rgba="0 0 0 1" />
            </material>
        </visual>
    </link>
    <link name="deck_link">
        <inertial>
            <mass value="7.67011e-05" />
            <origin xyz="-0.0766458 0.0499738 0.00251571" rpy="0 -0 0" />
            <inertia ixx="8.87039e-08" ixy="-8.69793e-11" ixz="4.28117e-11" iyy="1.17774e-07" iyz="-1.96015e-14" izz="2.06151e-07" />
        </inertial>
        <visual>
            <origin xyz="-0.0783612 0.05 0" rpy="0 -0 0" />
            <geometry>
                <mesh filename="package://main_assembly/meshes/deck_link.stl" scale="1 1 1" />
            </geometry>
            <material name="0.615686_0.811765_0.929412_0.000000_0.000000">
                <color rgba="0.615686 0.811765 0.929412 1" />
            </material>
        </visual>
    </link>
    <link name="driver_board_link">
        <inertial>
            <mass value="4.89491e-06" />
            <origin xyz="8.10699e-11 0.0244448 -0.00409501" rpy="0 -0 0" />
            <inertia ixx="4.35323e-10" ixy="0" ixz="0" iyy="1.09988e-09" iyz="-2.76617e-12" izz="1.51086e-09" />
        </inertial>
        <visual>
            <origin xyz="-0.01127 0.02501 -0.00125" rpy="0 -0 0" />
            <geometry>
                <mesh filename="package://main_assembly/meshes/driver_board_link.stl" scale="1 1 1" />
            </geometry>
            <material name="0.768627_0.886275_0.952941_0.000000_0.000000">
                <color rgba="0.768627 0.886275 0.952941 1" />
            </material>
        </visual>
    </link>
    <link name="imu_link">
        <inertial>
            <mass value="9.34871e-07" />
            <origin xyz="0.000466457 -9.8048e-05 -0.00171489" rpy="0 -0 0" />
            <inertia ixx="2.7347e-11" ixy="6.31926e-13" ixz="-8.2028e-13" iyy="5.10439e-11" iyz="1.55278e-13" izz="7.72887e-11" />
        </inertial>
        <visual>
            <origin xyz="0.008255 0.00508 -0.00275" rpy="0 -0 0" />
            <geometry>
                <mesh filename="package://main_assembly/meshes/imu_link.stl" scale="1 1 1" />
            </geometry>
            <material name="1.000000_1.000000_1.000000_0.000000_0.000000">
                <color rgba="1 1 1 1" />
            </material>
        </visual>
    </link>
    <link name="laser">
        <inertial>
            <mass value="3.23157e-05" />
            <origin xyz="8.41462e-05 -9.44507e-05 -0.0165779" rpy="0 -0 0" />
            <inertia ixx="1.41413e-08" ixy="-2.23006e-12" ixz="2.21212e-11" iyy="1.40971e-08" iyz="-1.67404e-11" izz="1.99332e-08" />
        </inertial>
        <visual>
            <origin xyz="-2.3726e-19 -4.2615e-17 -0.0305964" rpy="0 -0 0" />
            <geometry>
                <mesh filename="package://main_assembly/meshes/laser.stl" scale="1 1 1" />
            </geometry>
            <material name="0.156863_0.156863_0.156863_0.000000_0.000000">
                <color rgba="0.156863 0.156863 0.156863 1" />
            </material>
        </visual>
    </link>
    <link name="motor_driver_left_link">
        <inertial>
            <mass value="1.87625e-06" />
            <origin xyz="-0.0127238 -0.00396475 0.00880106" rpy="0 -0 0" />
            <inertia ixx="8.87806e-11" ixy="-1.70994e-11" ixz="-6.76803e-12" iyy="1.44367e-10" iyz="2.57579e-12" izz="1.00757e-10" />
        </inertial>
        <visual>
            <origin xyz="-0.06707 0 0.0005" rpy="0 -0 0" />
            <geometry>
                <mesh filename="package://main_assembly/meshes/motor_driver_left_link.stl" scale="1 1 1" />
            </geometry>
            <material name="0.768627_0.886275_0.952941_0.000000_0.000000">
                <color rgba="0.768627 0.886275 0.952941 1" />
            </material>
        </visual>
    </link>
    <link name="motor_driver_right_link">
        <inertial>
            <mass value="1.87625e-06" />
            <origin xyz="-0.0127238 -0.00396475 -0.00739894" rpy="0 -0 0" />
            <inertia ixx="8.87806e-11" ixy="-1.70994e-11" ixz="-6.76803e-12" iyy="1.44367e-10" iyz="2.57579e-12" izz="1.00757e-10" />
        </inertial>
        <visual>
            <origin xyz="-0.06707 0 -0.0497" rpy="0 -0 0" />
            <geometry>
                <mesh filename="package://main_assembly/meshes/motor_driver_right_link.stl" scale="1 1 1" />
            </geometry>
            <material name="0.768627_0.886275_0.952941_0.000000_0.000000">
                <color rgba="0.768627 0.886275 0.952941 1" />
            </material>
        </visual>
    </link>
    <link name="motor_left_link">
        <inertial>
            <mass value="2.4232e-05" />
            <origin xyz="3.52782e-06 1.18369e-06 -0.0247986" rpy="0 -0 0" />
            <inertia ixx="6.23821e-09" ixy="1.51175e-12" ixz="4.03364e-13" iyy="6.23998e-09" iyz="7.15374e-13" izz="1.84251e-09" />
        </inertial>
        <visual>
            <origin xyz="4.03494e-06 4.21546e-08 -0.021" rpy="0 -0 0" />
            <geometry>
                <mesh filename="package://main_assembly/meshes/motor_left_link.stl" scale="1 1 1" />
            </geometry>
            <material name="0.800000_0.800000_0.800000_0.000000_0.000000">
                <color rgba="0.8 0.8 0.8 1" />
            </material>
        </visual>
    </link>
    <link name="motor_mount_left_link">
        <inertial>
            <mass value="4.05041e-06" />
            <origin xyz="-0.00815 0.0010031 0.00895425" rpy="0 -0 0" />
            <inertia ixx="8.18103e-10" ixy="0" ixz="0" iyy="6.21383e-10" iyz="-2.39803e-10" izz="6.74037e-10" />
        </inertial>
        <visual>
            <origin xyz="-0.00815 -0.0223 0" rpy="0 -0 0" />
            <geometry>
                <mesh filename="package://main_assembly/meshes/motor_mount_left_link.stl" scale="1 1 1" />
            </geometry>
            <material name="0.262745_0.282353_0.301961_0.000000_0.000000">
                <color rgba="0.262745 0.282353 0.301961 1" />
            </material>
        </visual>
    </link>
    <link name="motor_mount_right_link">
        <inertial>
            <mass value="4.05041e-06" />
            <origin xyz="0.00815 0.0010031 0.00895425" rpy="0 -0 0" />
            <inertia ixx="8.18103e-10" ixy="0" ixz="0" iyy="6.21383e-10" iyz="-2.39803e-10" izz="6.74037e-10" />
        </inertial>
        <visual>
            <origin xyz="0.00815 -0.0223 0" rpy="0 -0 0" />
            <geometry>
                <mesh filename="package://main_assembly/meshes/motor_mount_right_link.stl" scale="1 1 1" />
            </geometry>
            <material name="0.262745_0.282353_0.301961_0.000000_0.000000">
                <color rgba="0.262745 0.282353 0.301961 1" />
            </material>
        </visual>
    </link>
    <link name="motor_right_link">
        <inertial>
            <mass value="2.4232e-05" />
            <origin xyz="-5.07116e-07 1.14154e-06 -0.0247986" rpy="0 -0 0" />
            <inertia ixx="6.23821e-09" ixy="1.51175e-12" ixz="4.03361e-13" iyy="6.23998e-09" iyz="7.15371e-13" izz="1.84251e-09" />
        </inertial>
        <visual>
            <origin xyz="0 -0.0338 -0.021" rpy="0 -0 0" />
            <geometry>
                <mesh filename="package://main_assembly/meshes/motor_right_link.stl" scale="1 1 1" />
            </geometry>
            <material name="0.800000_0.800000_0.800000_0.000000_0.000000">
                <color rgba="0.8 0.8 0.8 1" />
            </material>
        </visual>
    </link>
    <link name="pi_link">
        <inertial>
            <mass value="2.29908e-05" />
            <origin xyz="0.0563352 0.0234255 0.00545939" rpy="0 -0 0" />
            <inertia ixx="6.64877e-09" ixy="-4.90206e-11" ixz="-1.58651e-09" iyy="1.52185e-08" iyz="-4.52681e-11" izz="2.07467e-08" />
        </inertial>
        <visual>
            <origin xyz="0.039 0.0245 0" rpy="0 -0 0" />
            <geometry>
                <mesh filename="package://main_assembly/meshes/pi_link.stl" scale="1 1 1" />
            </geometry>
            <material name="0.862745_0.862745_0.862745_0.000000_0.000000">
                <color rgba="0.862745 0.862745 0.862745 1" />
            </material>
        </visual>
    </link>
    <link name="pi_mount_link">
        <inertial>
            <mass value="1.09201e-05" />
            <origin xyz="-0.0100059 0.0280027 0.0016171" rpy="0 -0 0" />
            <inertia ixx="3.20565e-09" ixy="1.89968e-12" ixz="5.66429e-14" iyy="4.19035e-09" iyz="-2.74213e-14" izz="7.36865e-09" />
        </inertial>
        <visual>
            <origin xyz="-4.27562e-05 0.028 0.007" rpy="0 -0 0" />
            <geometry>
                <mesh filename="package://main_assembly/meshes/pi_mount_link.stl" scale="1 1 1" />
            </geometry>
            <material name="0.980392_0.713725_0.003922_0.000000_0.000000">
                <color rgba="0.980392 0.713726 0.00392157 1" />
            </material>
        </visual>
    </link>
    <link name="power_bracket_link">
        <inertial>
            <mass value="1.64647e-05" />
            <origin xyz="-0.00111389 -0.00773123 0.0204898" rpy="0 -0 0" />
            <inertia ixx="4.44442e-09" ixy="2.07263e-11" ixz="-4.07847e-12" iyy="9.06578e-09" iyz="-8.83554e-13" izz="5.78195e-09" />
        </inertial>
        <visual>
            <origin xyz="0.0111 -0.01275 0.0196" rpy="0 -0 0" />
            <geometry>
                <mesh filename="package://main_assembly/meshes/power_bracket_link.stl" scale="1 1 1" />
            </geometry>
            <material name="0.972549_0.529412_0.003922_0.000000_0.000000">
                <color rgba="0.972549 0.529412 0.00392157 1" />
            </material>
        </visual>
    </link>
    <link name="root" />
    <link name="wheel_left_link">
        <inertial>
            <mass value="3.20155e-05" />
            <origin xyz="-1.02631e-07 -0.00190802 5.70451e-07" rpy="0 -0 0" />
            <inertia ixx="9.72681e-09" ixy="-3.77314e-14" ixz="1.2383e-14" iyy="1.54551e-08" iyz="-9.79734e-14" izz="9.72576e-09" />
        </inertial>
        <visual>
            <origin xyz="0 0.004 0" rpy="0 -0 0" />
            <geometry>
                <mesh filename="package://main_assembly/meshes/wheel_left_link.stl" scale="1 1 1" />
            </geometry>
            <material name="0.329412_0.329412_0.329412_0.000000_0.000000">
                <color rgba="0.329412 0.329412 0.329412 1" />
            </material>
        </visual>
    </link>
    <link name="wheel_right_link">
        <inertial>
            <mass value="3.20155e-05" />
            <origin xyz="-1.02631e-07 -0.00190802 5.70451e-07" rpy="0 -0 0" />
            <inertia ixx="9.72681e-09" ixy="-3.77314e-14" ixz="1.2383e-14" iyy="1.54551e-08" iyz="-9.79734e-14" izz="9.72576e-09" />
        </inertial>
        <visual>
            <origin xyz="0 -0.046 0" rpy="0 -0 0" />
            <geometry>
                <mesh filename="package://main_assembly/meshes/wheel_right_link.stl" scale="1 1 1" />
            </geometry>
            <material name="0.329412_0.329412_0.329412_0.000000_0.000000">
                <color rgba="0.329412 0.329412 0.329412 1" />
            </material>
        </visual>
    </link>
    <joint name="base_joint" type="fixed">
        <origin xyz="-0.038146 0 0.053104" rpy="0 -0 0" />
        <axis xyz="0 0 1" />
        <parent link="root" />
        <child link="base_link" />
    </joint>
    <joint name="battery_joint" type="fixed">
        <origin xyz="-0.0306365 5.51219e-11 0.005" rpy="-3.14159 -2.1684e-19 -6.66134e-16" />
        <axis xyz="-2.1684e-19 -1.38778e-17 1" />
        <parent link="battery_tray_link" />
        <child link="battery_link" />
    </joint>
    <joint name="battery_tray_joint" type="fixed">
        <origin xyz="0.0717888 0 0.005" rpy="-1.33227e-15 1.33227e-15 7.21645e-16" />
        <axis xyz="0 0 -1" />
        <parent link="base_link" />
        <child link="battery_tray_link" />
    </joint>
    <joint name="camera_joint" type="fixed">
        <origin xyz="0.0150907 -0.015 0.00762285" rpy="1.2326e-32 -3.00315e-07 3.26265e-55" />
        <axis xyz="-6.12323e-17 1.2326e-32 1" />
        <parent link="camera_mount_link" />
        <child link="camera_link" />
    </joint>
    <joint name="camera_mount_joint" type="fixed">
        <origin xyz="-0.0257 0.065 0.005" rpy="0 0.349066 0" />
        <axis xyz="0.34202 -0 -0.939693" />
        <parent link="deck_link" />
        <child link="camera_mount_link" />
    </joint>
    <joint name="camera_optical_frame" type="fixed">
        <origin xyz="0.0208 -3.46945e-18 -0.015" rpy="-1.5708 -0 -1.5708" />
        <axis xyz="0 0 1" />
        <parent link="camera_link" />
        <child link="camera_optical_frame" />
    </joint>
    <joint name="caster_fork_joint" type="fixed">
        <origin xyz="0.023 1.73472e-18 0.042" rpy="1.38778e-16 -8.49836e-29 -5.55112e-17" />
        <axis xyz="0 0 1" />
        <parent link="caster_mount_link" />
        <child link="caster_fork_link" />
    </joint>
    <joint name="caster_mount_joint" type="fixed">
        <origin xyz="0.15815 1.99493e-17 0" rpy="-3.14159 2.05486e-16 3.14159" />
        <axis xyz="0 0 -1" />
        <parent link="base_link" />
        <child link="caster_mount_link" />
    </joint>
    <joint name="caster_wheel_joint" type="fixed">
        <origin xyz="0 0 3.46945e-18" rpy="-4.71845e-16 3.99823e-31 3.88578e-16" />
        <axis xyz="0 0 1" />
        <parent link="caster_fork_link" />
        <child link="caster_wheel_link" />
    </joint>
    <joint name="dcdc_joint" type="fixed">
        <origin xyz="-0.02335 -0.01345 0.005" rpy="0 -0 0" />
        <axis xyz="0 1 0" />
        <parent link="power_bracket_link" />
        <child link="dcdc_link" />
    </joint>
    <joint name="deck_joint" type="fixed">
        <origin xyz="0.15015 -0.05 0.065" rpy="0 -0 0" />
        <axis xyz="0 0 1" />
        <parent link="base_link" />
        <child link="deck_link" />
    </joint>
    <joint name="driver_board_joint" type="fixed">
        <origin xyz="0.081575 -0.078 0" rpy="-5.55112e-16 3.33067e-16 6.12323e-17" />
        <axis xyz="-0 1 -0" />
        <parent link="base_link" />
        <child link="driver_board_link" />
    </joint>
    <joint name="imu_joint" type="fixed">
        <origin xyz="-0.112165 0.05 0.01075" rpy="0 -0 0" />
        <axis xyz="0 0 1" />
        <parent link="deck_link" />
        <child link="imu_link" />
    </joint>
    <joint name="laser_joint" type="fixed">
        <origin xyz="-0.0664496 0.05 0.035596" rpy="1.40166e-15 -1.38778e-17 0" />
        <axis xyz="1.38778e-17 1.40166e-15 1" />
        <parent link="deck_link" />
        <child link="laser" />
    </joint>
    <joint name="motor_driver_left_joint" type="fixed">
        <origin xyz="0.01924 0.0156 -0.007" rpy="1.5708 4.996e-16 -1.5708" />
        <axis xyz="0 1 0" />
        <parent link="driver_board_link" />
        <child link="motor_driver_left_link" />
    </joint>
    <joint name="motor_driver_right_joint" type="fixed">
        <origin xyz="-0.01924 0.0156 -0.007" rpy="1.5708 4.44089e-16 -1.5708" />
        <axis xyz="0 1 0" />
        <parent link="driver_board_link" />
        <child link="motor_driver_right_link" />
    </joint>
    <joint name="motor_left_joint" type="fixed">
        <origin xyz="-0.00815 0.00745 0.0206" rpy="1.5708 -5.55112e-16 3.14159" />
        <axis xyz="0 0 1" />
        <parent link="motor_mount_left_link" />
        <child link="motor_left_link" />
    </joint>
    <joint name="motor_mount_left_joint" type="fixed">
        <origin xyz="0.03 0.06755 0" rpy="-3.14159 2.05486e-16 3.14159" />
        <axis xyz="0 0 -1" />
        <parent link="base_link" />
        <child link="motor_mount_left_link" />
    </joint>
    <joint name="motor_mount_right_joint" type="fixed">
        <origin xyz="0.03 -0.06755 0" rpy="3.14159 -4.05018e-16 1.94289e-16" />
        <axis xyz="0 0 -1" />
        <parent link="base_link" />
        <child link="motor_mount_right_link" />
    </joint>
    <joint name="motor_right_joint" type="fixed">
        <origin xyz="0.00815 0.00745 0.0206" rpy="-1.5708 -2.498e-16 -1.17882e-16" />
        <axis xyz="0 0 1" />
        <parent link="motor_mount_right_link" />
        <child link="motor_right_link" />
    </joint>
    <joint name="pi_joint" type="fixed">
        <origin xyz="-0.0390428 0.0035 0.007" rpy="6.51193e-16 -9.51968e-18 -5.20656e-17" />
        <axis xyz="-0 -0 -1" />
        <parent link="pi_mount_link" />
        <child link="pi_link" />
    </joint>
    <joint name="pi_mount_joint" type="fixed">
        <origin xyz="0.15815 1.99493e-17 0.005" rpy="-1.69318e-16 3.61723e-16 1.5708" />
        <axis xyz="-0 -0 -1" />
        <parent link="base_link" />
        <child link="pi_mount_link" />
    </joint>
    <joint name="power_bracket_joint" type="fixed">
        <origin xyz="0.094575 0.063 0" rpy="1.5708 -0 0" />
        <axis xyz="0 1 0" />
        <parent link="base_link" />
        <child link="power_bracket_link" />
    </joint>
    <joint name="wheel_left_joint" type="continuous">
        <origin xyz="-0.000128278 6.29059e-08 0.0205" rpy="-1.5708 -8.30461e-31 3.14159" />
        <axis xyz="0 -1 0" />
        <parent link="motor_left_link" />
        <child link="wheel_left_link" />
    </joint>
    <joint name="wheel_right_joint" type="continuous">
        <origin xyz="-0.000132313 2.07513e-08 0.0205" rpy="-1.5708 2.18632e-30 -1.64402e-17" />
        <axis xyz="0 1 0" />
        <parent link="motor_right_link" />
        <child link="wheel_right_link" />
    </joint>
</robot>
