MatthieuGrr/alidade_ros2/alidade_bringup/config/controllers.yaml

# Controleurs ros2_control, communs au robot reel et a la simulation.
#
# Gabarit : chaque marqueur (dollar, accolades, cle pointee) est rempli au lancement depuis la revision
# materielle (alidade_description/config/alidade_<rev>.yaml). Ne pas y
# recopier de valeur physique.

controller_manager:
  ros__parameters:
    # Cale sur la cadence des trames du Pico : un cycle par trame, ni plus
    # (deltas de position nuls un cycle sur deux) ni moins.
    update_rate: ${pico.frame_rate_hz}
    use_sim_time: ${use_sim_time}

    # Diagnostics de ros2_control. Les seuils par defaut de l'ecart-type des
    # temps d'execution (100 / 200 us) visent une boucle temps reel ; ici elle
    # est cadencee par les trames USB du Pico sur un noyau ordinaire. MESURE
    # au repos : moyennes de 20 a 83 us pour un cycle de 20 ms (0.4 % du
    # budget), ecarts-types de 87 a 258 us, gonfles par de rares pics de 6 ms
    # au demarrage que ces statistiques cumulees ne relachent jamais. On elargit
    # donc l'ecart-type -- 1 ms reste 5 % du cycle -- et on garde les seuils de
    # la MOYENNE et de la periodicite aux valeurs par defaut : ce sont eux qui
    # disent si la boucle tient. La periodicite mesuree est de 50.06 Hz avec un
    # ecart-type de 1.99 Hz, bien dans les clous.
    diagnostics.threshold.controllers.execution_time.standard_deviation.warn: 500.0
    diagnostics.threshold.controllers.execution_time.standard_deviation.error: 1000.0
    diagnostics.threshold.hardware_components.execution_time.standard_deviation.warn: 500.0
    diagnostics.threshold.hardware_components.execution_time.standard_deviation.error: 1000.0

    joint_state_broadcaster:
      type: joint_state_broadcaster/JointStateBroadcaster
    diff_drive_controller:
      type: diff_drive_controller/DiffDriveController
    imu_sensor_broadcaster:
      type: imu_sensor_broadcaster/IMUSensorBroadcaster

diff_drive_controller:
  ros__parameters:
    use_sim_time: ${use_sim_time}
    left_wheel_names: ["wheel_left_joint"]
    right_wheel_names: ["wheel_right_joint"]

    wheel_separation: ${kinematics.wheel_separation}
    wheel_radius: ${kinematics.wheel_radius}

    base_frame_id: base_footprint
    odom_frame_id: odom
    publish_rate: 50.0
    # gyro_odom.py publie le repere odom -> base_footprint, avec le cap du
    # gyromètre ; deux sources pour la meme transformation se disputeraient.
    # Son odometrie roues reste publiee, et sert de temoin.
    enable_odom_tf: false
    open_loop: false
    position_feedback: true
    # Le twist est derive des positions a 50 Hz : a 0.5 rad/s une roue avance
    # de 7 ticks par cycle, et le ±1 tick de quantification fait ±11 % sur la
    # vitesse publiee avec une fenetre de 5 (mesure : 0.42-0.54 rad/s pour
    # 0.485 de moyenne). La pose n'est pas concernee. A 10, le bruit tombe de
    # moitie pour 100 ms de retard sur la vitesse seule ; c'est cette vitesse
    # que le pure pursuit utilise pour dimensionner son point de visee.
    velocity_rolling_window_size: 10
    # Au-dela, sans nouvelle consigne, le controleur envoie zero : le Pico
    # reçoit donc toujours des trames et son chien de garde ne tombe pas.
    cmd_vel_timeout: 0.5

    # Le firmware n'applique aucune limite : c'est ici, cote Pi, qu'elles
    # vivent. Une limite en NaN est desactivee.
    linear.x.max_velocity: ${motor.max_linear_velocity}
    linear.x.min_velocity: -${motor.max_linear_velocity}
    linear.x.max_acceleration: ${motor.max_linear_acceleration}
    linear.x.max_deceleration: -${motor.max_linear_acceleration}
    angular.z.max_velocity: ${motor.max_angular_velocity}
    angular.z.min_velocity: -${motor.max_angular_velocity}
    angular.z.max_acceleration: ${motor.max_angular_acceleration}
    angular.z.max_deceleration: -${motor.max_angular_acceleration}

imu_sensor_broadcaster:
  ros__parameters:
    use_sim_time: ${use_sim_time}
    sensor_name: imu
    frame_id: ${imu.frame}
    # Le BNO055 est lu en brut (gyroscope + accelerometre), sans orientation :
    # -1 en premiere case signale « pas d'estimation » selon sensor_msgs/Imu.
    static_covariance_orientation: [-1.0, 0.0, 0.0, 0.0, 0.0, 0.0, 0.0, 0.0, 0.0]
    static_covariance_angular_velocity: [0.0, 0.0, 0.0, 0.0, 0.0, 0.0, 0.0, 0.0, 0.0]
    static_covariance_linear_acceleration: [0.0, 0.0, 0.0, 0.0, 0.0, 0.0, 0.0, 0.0, 0.0]
