MatthieuGrr/alidade_ros2/alidade_description/config/alidade_v2.yaml

# Révision matérielle v2 d'Alidade.
#
# Ce fichier est LA source de toutes les constantes physiques du robot. Le
# xacro, controllers.yaml et nav2.yaml lisent ici ; aucune valeur ne doit être
# recopiée à la main ailleurs. Une révision suivante est un second fichier de
# ce format, sélectionné par l'argument hardware_revision, sans toucher au code.
#
# Les valeurs sont mesurées, pas déduites de fiches techniques — voir chaque
# section. Celles qui ne le sont pas ENCORE sont listées dans `provisional`,
# et le build les rappelle à chaque compilation.
#
# ---------------------------------------------------------------------------
# CE QUI CHANGE DEPUIS v1 (châssis entièrement redessiné, sept. 2026). La v1
# décrivait un robot qui n'existe plus ; elle a été supprimée, pas conservée.
#
#   plateau     158 × 156 mm        ->  250 × 252 mm
#   roues       Ø64 × 30 mm         ->  Ø99.6 × 24 mm
#   entraxe     191 mm (CAO)        ->  225 mm (CAO)
#   roulette    bille Ø22 à l'AVANT ->  Ø50 à l'ARRIÈRE, 70.6 mm de haut
#   LiDAR       x +45.6, z 153.7    ->  x -99.8, z 165.2
#   caméra      C920 sur support 20°->  RealSense D435i
#   encombrement 209 × 217 mm       ->  254 × 252 × 176 mm
#
# Les moteurs, le réducteur, les encodeurs, le Pi, la batterie, le LiDAR et
# l'IMU sont les MÊMES pièces : leurs volumes d'export sont identiques au
# centième près. Tout ce qui les concerne est repris de v1 sans réserve.
#
# base_footprint reste au sol sur l'axe des roues, mais cet axe n'est plus au
# milieu du robot : 55 mm de la face avant, 199 mm de l'arrière.

revision: v2

# Export URDF Onshape corrigé par scripts/fix_urdf.py, relatif à urdf/.
onshape_export: onshape/alidade_v2.urdf

# Valeurs pas encore mesurées sur CE châssis : reprises de la CAO ou de la
# révision précédente. fix_urdf.py les rappelle à chaque build pour qu'aucune
# ne s'installe par habitude. Retirer une entrée d'ici est la dernière étape
# d'une mesure, jamais la première.
provisional:
  motor.max_linear_acceleration: déduit du couple, pas mesuré (voir motor)
  masses.base_link: pesée de la v1, châssis depuis agrandi
  masses.wheel_left_link: pesée des roues Ø64
  masses.wheel_right_link: pesée des roues Ø64

# ---------------------------------------------------------------------------
# Cinématique différentielle.
kinematics:
  # CALIBRÉS au sol le 29 septembre 2026, le LiDAR pour juge, ni SLAM ni IMU.
  #
  #  - RAYON : deux lignes droites d'un mètre à 0.15 m/s, ICP 2D des nuages
  #    avant/après (326 et 329 appariements). L'odométrie sur-estime de 0.55 %
  #    et 0.77 %, soit 0.66 % en moyenne → rayon de roulement 49.67 mm. La CAO
  #    donne un disque de 99.6 mm, soit 49.8 de rayon : le pneu chargé roule
  #    0.3 % plus petit que sa cote, ce qui est l'écrasement attendu.
  #
  #  - ENTRAXE : deux tours complets dans CHAQUE sens, profils de scan corrélés
  #    circulairement. L'odométrie sur-estime la rotation de 1.0241 (anti-horaire)
  #    et 1.0242 (horaire) — identiques à 0.01 % près, sans le biais unilatéral
  #    qu'avait la v1. En retirant l'effet du rayon, l'entraxe efficace vaut
  #    228.92 mm contre 225.0 en CAO : +1.74 %, l'élargissement classique dû à
  #    la surface de contact du pneu.
  #
  # PRÉ-ALIGNER LA ROULETTE avant toute mesure : elle est PIVOTANTE et porte la
  # moitié du poids. Si elle doit se retourner pendant l'essai, elle fausse
  # tout — une campagne entière a conclu à une zone morte moteur qui n'était
  # que son couple de retournement. Faire quelques dizaines de centimètres dans
  # le sens de la mesure avant de lancer, et ne jamais inverser en cours de
  # série.
  #
  #   ros2 run alidade_bringup odom_calib.py straight 1.0 0.15
  #   ros2 run alidade_bringup odom_calib.py rotate 2 0.6    (et -2 pour l'autre sens)
  #
  # La simulation suit : disques de collision au rayon effectif et décalés pour
  # donner le même entraxe efficace (voir collisions).
  wheel_separation: 0.2289
  wheel_radius: 0.0497
  # 11 PPR × 4 (quadrature) × 34:1. MESURÉ sur 10 tours de roue à la main
  # (14 960 ticks) : le réducteur livré est en 34:1 et non 35:1. Se tromper
  # coûte 2.9 % sur les distances et 10° sur un tour complet du robot.
  counts_per_rev: 1496

# Motorisation, pour borner les consignes côté Pi : le firmware n'applique
# aucune limite et exécute la consigne telle quelle.
motor:
  rated_rpm: 170           # GA25-370 à 24 V, en sortie de réducteur
  # Vitesses de croisière retenues pour ce robot. Les roues Ø100 portent la
  # pleine échelle de 0.58 à 0.89 m/s : les plafonds ci-dessous, inchangés,
  # laissent donc encore plus de marge au PID du Pico qu'en v1.
  max_linear_velocity: 0.40     # m/s
  max_angular_velocity: 2.50    # rad/s
  # DÉDUIT, pas mesuré. À couple moteur identique, une roue 1.534 fois plus
  # grande donne 1.534 fois moins de force au sol : le 1.0 m/s² de la v1
  # devient 0.65. Une consigne d'accélération que les moteurs ne peuvent pas
  # tenir ne se voit pas — le PID sature en silence et le robot part de
  # travers. À vérifier au banc, montre en main, avant de remonter.
  max_linear_acceleration: 0.65 # m/s²
  max_angular_acceleration: 3.5 # rad/s², à revérifier : l'inertie a augmenté
  # MESURÉ au banc le 7 octobre 2026 (consigne de roue contre vitesse atteinte,
  # lue dans /joint_states). La boucle du Pico est excellente là où elle
  # travaille — gain 1.00 à 1.03, asymétrie gauche/droite ≤ 2 % — mais elle a un
  # plancher de frottement sec :
  #
  #   ≤ 0.15 rad/s de roue   les deux roues restent EXACTEMENT à zéro
  #   0.2 à 0.6 rad/s        collage-décollage, gain de 0.24 à 1.35 d'un essai
  #                          à l'autre à consigne identique, non reproductible
  #   ≥ 0.7 rad/s            propre, gain 1.00 ± 0.03
  #
  # Identique en rotation sur place et en ligne droite (vérifié) : la roue folle
  # n'y est pour rien, c'est le motoréducteur. Ne pas asservir sous ce plancher ;
  # nav2 n'y descend pas (regulated_linear_scaling_min_speed 0.10 m/s, soit
  # 2.0 rad/s de roue, et rotate_to_heading_angular_vel 1.0 rad/s).
  min_wheel_velocity: 0.7       # rad/s, en deçà l'asservissement n'est pas fiable

# ---------------------------------------------------------------------------
# Empreinte, depuis base_footprint. Mesurée sur l'enveloppe des maillages de
# l'export, origines de `visual` comprises — un maillage Onshape vit dans le
# repère de sa pièce, et lire sa boîte englobante sans cette origine donne des
# robots asymétriques qui n'existent pas.
#
# ATTENTION : l'axe des roues n'est plus au milieu du robot. base_footprint est
# à 55 mm de la face avant et à 199 mm de l'arrière. Le modèle CIRCULAIRE de
# nav2 (robot_radius) est donc très conservateur devant — il réserve 235 mm
# là où 55 suffisent. Une empreinte polygonale rendrait au robot 18 cm de
# dégagement frontal ; à décider quand la navigation reprendra.
footprint:
  circumscribed_radius: 0.2347 # coin arrière du plateau, le point le plus loin
  robot_radius: 0.24           # valeur nav2, arrondie au-dessus
  length: 0.2541               # encombrement au sol, selon X (-0.1992 .. +0.0549)
  width: 0.2520                # selon Y, pneus compris (±0.126)
  # Point le plus haut : le LiDAR, dont le corps dépasse de 10.7 mm le plan de
  # scan (origine visuelle du maillage à -30.6 mm, enveloppe +41.3 mm). Suit
  # donc `frames.expected.laser` : 0.1742 + 0.0107. La caméra culmine vers
  # 0.166 m, plus bas. Valeur DOCUMENTAIRE, aucun code ne la lit.
  height: 0.1849
  front_x: 0.052               # face avant du plateau ; depuis le ré-export du
                               # 28 sept. 2026 la caméra ne dépasse plus (0.025)

# ---------------------------------------------------------------------------
# Poses attendues des repères principaux, exprimées depuis base_footprint.
# Ce ne sont PAS des valeurs d'entrée : la géométrie vient de l'export Onshape.
# fix_urdf.py vérifie que l'export les respecte et fait échouer le build sinon,
# pour qu'un réexport qui a bougé se voie immédiatement.
frames:
  tolerance: 0.001             # m
  expected:
    base_link:            [ 0.0520,  0.0,     0.0706]
    wheel_left_link:      [ 0.0,     0.1125,  0.0500]
    wheel_right_link:     [ 0.0,    -0.1125,  0.0500]
    # Ré-export du 8 octobre 2026, recalé sur le robot PHYSIQUE : le LiDAR est
    # monté de 9.0 mm (laser_joint 0.0895963 -> 0.0985963) et un maillon
    # `camera_adaptor` s'intercale entre base_link et camera_mount_link, qui
    # recule de 43.5 mm et monte de 25.0 mm (écart total 50.17 mm). Les deux
    # rotations de pi de l'adaptateur s'annulent : la caméra regarde toujours
    # +x, sans inclinaison.
    laser:                [-0.0998,  0.0,     0.1742]
    imu_link:             [-0.0019, -0.0026,  0.0660]
    camera_mount_link:    [-0.0315,  0.0,     0.1406]
    caster_wheel_link:    [-0.1888,  0.0187,  0.0706]

# ---------------------------------------------------------------------------
# Corrections propres à l'exporteur Onshape.

# Racine synthétique fabriquée par l'exporteur, sur laquelle la CAO ne donne
# aucune prise. base_footprint est au sol, au milieu de l'axe des roues.
rename_root:
  from: root
  to: base_footprint

# Plus aucun renommage de link ni de joint : l'export sort `camera_mount_link`
# et `camera_mount_joint`, qui n'entrent en collision avec rien. La macro
# `sensor_d435i` crée ses propres `camera_link` et `camera_joint` ; tant que la
# CAO ne les revendique pas, il n'y a rien à arbitrer. Si un jour un export
# ramène l'homonymie, `rename_links` et `rename_joints` existent toujours dans
# fix_urdf.py, et le message d'erreur dit quoi ajouter ici.

# Masses pesées à la balance, en kg. L'exporteur ne transmet pas les
# matériaux : tout sort à une densité de 1 kg/m³. Comme cette densité est
# uniforme, chaque tenseur d'inertie est juste à un facteur près, et le
# corriger revient à le multiplier par m_mesurée / m_exportée.
#
# Seuls les corps qui pèsent sont listés. Les autres links gardent leur masse
# d'export (quelques dixièmes de gramme) : ce sont des porteurs de repère dont
# la masse est déjà comptée dans base_link. Total : 1.598 kg.
# PESÉES DE LA v1, reprises telles quelles sauf la batterie. Le plateau a
# gagné 166 cm³ de matière, le deck 71, et chaque roue est passée de 32 à
# 168 cm³ : ces trois-là sont fausses et il n'y a aucun moyen honnête de les
# déduire (la masse de base_link agrège de l'électronique dont le volume n'a
# pas bougé). Balance, pas règle de trois.
masses:
  base_link: 1.051         # châssis complet : platines, moteurs, électronique, capteurs
  battery_link: 0.449      # même batterie qu'en v1, volume d'export identique
  wheel_left_link: 0.049   # jante + pneu — valeur des roues Ø64, À REPESER
  wheel_right_link: 0.049  # idem

# Géométries de collision. L'export n'en produit aucune, et les maillages
# visuels (37 Mo) sont injouables dans un moteur physique.
# Primitives de collision. L'export ne fournit que des maillages : Gazebo les
# accepte mais le solveur y perd, et un maillage de roue ne roule pas comme une
# roue. Chaque corps portant se voit donc donner une primitive.
collisions:
  base_link:
    shape: box
    # Enveloppe du corps, roues et roulette exclues : x -199.2..+54.9,
    # y ±126.0, z +36.9..+175.9 dans base_footprint.
    size: [0.2541, 0.2520, 0.1390]
    origin: [-0.1242, 0.0, 0.0358]
    mu: 0.2
  wheel_left_link:
    shape: cylinder
    # Rayon de roulement (kinematics.wheel_radius), pas la cote CAO : le
    # contrôleur et la simulation doivent voir la MÊME roue.
    radius: 0.0497
    # Disque fin volontairement : le solveur résout le contact cylindre/plan
    # sur un bord du cylindre, pas sous l'axe. Avec la largeur réelle du pneu,
    # l'entraxe efficace s'effondrait de 13.8 % en v1 ; à 4 mm, l'erreur
    # retombait à 2.0 %. Le pneu a changé, la ruse reste valable.
    length: 0.004
    # Décalage vers l'extérieur pour porter l'entraxe SIMULÉ à l'entraxe
    # calibré. MESURÉ en simulation, décalage nul : le solveur rend 221.0 mm,
    # le contact du disque ne tombant pas exactement dans son plan médian, et
    # c'est reproductible (0.0 mm d'écart entre les deux sens). Il faut donc
    # (228.9 - 221.0) / 2 = 3.96 mm par roue.
    #
    # À refaire si le rayon change ou après une nouvelle calibration :
    # ce décalage vaut (entraxe_voulu - entraxe_simulé_à_zéro) / 2.
    origin: [0.0, 0.00396, 0.0]
    rpy: [1.5708, 0.0, 0.0]   # l'axe d'un cylindre URDF est Z, la roue tourne sur Y
    mu: 1.2
  wheel_right_link:
    shape: cylinder
    radius: 0.0497
    length: 0.004
    origin: [0.0, -0.00396, 0.0]
    rpy: [1.5708, 0.0, 0.0]
    mu: 1.2
  caster_wheel_link:
    shape: sphere
    # La roulette fait Ø50.2 sur 70.6 mm de haut, son link étant en HAUT du
    # corps. Une sphère au point de contact (x -0.170, y 0, z +0.0251 dans
    # base_footprint) modélise le pivot sans que le solveur ait à le simuler.
    radius: 0.0251
    origin: [0.0188, -0.0187, -0.0455]
    mu: 0.01                 # glisse au lieu de freiner en virage

# Depuis la v2, le LiDAR est le point le plus haut du robot (165.2 mm, contre
# 135.1 pour le Pi qui vient ensuite) : plus rien ne l'occulte, le tour complet
# est exploitable. Il a reculé de 145.8 mm et monté de 11.5 mm par rapport à la
# v1, où il regardait par-dessus un châssis plus encombré.
lidar:
  frame: laser
  # Orientation du repère de MESURE — PAS celle du capteur sur le châssis.
  #
  # Le matériel est monté droit : la flèche du dessus du C1 EST le 0° du
  # balayage (datasheet, figure 1-2 : l'axe de référence part du centre à
  # travers le triangle, à l'opposé du câble), et elle est alignée sur +x.
  # Ce π ne décrit donc pas un capteur retourné — il n'y en a jamais eu un.
  #
  # Ce qu'il corrige est une convention du PILOTE. sllidar_node.cpp publie
  # θ_ros = π − θ_brut (lignes 218-222) là où la conversion juste est
  # θ_ros = −θ_brut : Slamtec compte les angles dans le sens horaire, ROS dans
  # le sens trigonométrique. Le repère nommé `laser` dans les messages /scan
  # est donc bel et bien tourné d'un demi-tour par rapport au capteur, et le
  # déclarer ici est exact.
  #
  # MESURÉ le 6 octobre 2026 : objet posé à l'arrière-droit du robot, rapporté
  # à +42° là où on l'attend à −135°. Soit −135 + 180, un demi-tour pur, sans
  # miroir (un miroir aurait donné +135, miroir et demi-tour −45).
  #
  # Cette correction a déjà vécu ici, puis est partie le 28 septembre 2026 vers
  # `flip_x_axis: true` de config/rplidar.yaml, au motif que le modèle doit
  # décrire le matériel et non compenser un pilote. Elle revient parce que
  # sllidar_node N'A PAS ce paramètre : ses seuls réglages sont channel_type,
  # serial_port, serial_baudrate, frame_id, inverted, angle_compensate,
  # scan_mode, scan_frequency et les variantes TCP/UDP. `inverted` ne convient
  # pas, il fait un miroir et non une rotation.
  #
  # Il n'y a donc PLUS de réglage équivalent côté pilote : ne pas chercher à en
  # ajouter un, et surtout ne pas corriger aux deux endroits à la fois.
  # Contrôle : scripts/lidar_zero.py.
  mount_rpy: [0.0, 0.0, 3.141592653589793]
  rotation_hz: 10            # 8-12 Hz possibles
  samples_per_rev: 500       # 5 kHz / 10 Hz, soit 0.72°
  range_min: 0.05
  range_max: 12.0            # objet blanc ; 6.0 sur objet noir
  range_resolution: 0.015
  accuracy: 0.030            # ±30 mm
  noise_stddev: 0.015        # ≈ 2 sigma pour ±30 mm
  serial_baudrate: 460800    # propre au C1

# CAMÉRA : Intel RealSense D435i, sur USB 3.
#
# La géométrie interne du capteur (décalages des centres optiques couleur,
# profondeur, infrarouge, et des deux modules inertiels) n'est PAS décrite ici :
# elle vient de `realsense2_description`, qui est la source amont. On ne fait
# qu'y accrocher notre point de fixation. Recopier ces cotes serait les figer à
# la version d'aujourd'hui pour rien.
#
# `camera_mount_link` (ex-`camera_link` de l'export) est le centre optique du
# capteur de PROFONDEUR, convention Intel. La macro s'attache par sa vis de
# fixation, qui est à (10.6, 17.5, 12.5) mm de ce centre : d'où le décalage
# négatif dans alidade.urdf.xacro. Un test vérifie que la chaîne retombe bien
# sur la position mesurée en CAO.
camera:
  frame: camera_color_optical_frame   # publié par le driver, ou par la macro en simulation
  mount_link: camera_mount_link
  # Décalage du point de fixation depuis `mount_link`. NUL : la CAO place le
  # repère directement sur le trou de fixation du D435i, qui est ce que la
  # macro attend.
  #
  # MESURÉ SUR LE ROBOT le 8 octobre 2026, premier branchement de la caméra, et
  # ce n'est plus une valeur provisoire. Méthode : ajustement RANSAC du plan du
  # SOL sur l'image de profondeur, ramené dans base_link par TF — contraint en
  # orientation seulement, jamais en position, donc sans circularité.
  #
  #   hauteur du centre optique   152.6 mm mesurés contre 153.1 modelés  -0.5 mm
  #   plan du sol                 +1.3 mm du z attendu
  #   inclinaison du montage      0.68 deg
  #   un mur, caméra contre LiDAR -1.3 mm (-0.20 %) et 0.42 deg
  #
  # 17 000 inliers de part et d'autre, résidus de 1.5 et 2.2 mm, et deux
  # capteurs indépendants qui concordent. Cette mesure a d'ailleurs DÉTECTÉ
  # l'erreur avant la correction CAO : elle annonçait la caméra 19 à 31 mm plus
  # haute que le modèle, et le ré-export recalé sur le robot physique l'a
  # relevée de 25.0 mm.
  #
  # C'est le bon partage : la CAO décrit une VIS, feature physique et mesurable ;
  # la géométrie interne du capteur reste chez son fabricant. Un décalage non nul
  # ici voudrait dire que le repère a glissé de la vis, pas qu'Intel a bougé.
  mount_offset: [0.0, 0.0, 0.0]
  # Nom de la caméra pour le driver ET pour la macro : c'est lui qui préfixe
  # tous les repères (`<name>_color_optical_frame`...). Les deux doivent être
  # d'accord, sinon les TF et les images ne parlent pas du même capteur.
  name: camera
  # Numéro de série, pour épingler l'exemplaire si un jour il y en a deux.
  # Vide = le driver prend la première caméra qu'il trouve.
  serial_no: ''
  # Flux couleur. 640x480 suffit pour de la détection de marqueurs et laisse de
  # la bande passante USB ; le D435i monte à 1920x1080 si besoin.
  width: 640
  height: 480
  # ENTIER OBLIGATOIRE, et c'est contre-intuitif : cette valeur part dans la
  # chaîne de profil `${camera.width}x${camera.height}x${camera.fps}` que le
  # pilote RealSense exige sous la forme `640x480x15`. Déclarée `15.0`, elle
  # rendait `640x480x15.0`, que le pilote REFUSE — en se rabattant en silence
  # sur 1280x720x30, soit 83 Mo/s au lieu de 13.8 sur un Pi 5. Mesuré le
  # 8 octobre 2026, premier branchement de la caméra. Les deux autres
  # consommateurs s'en moquent : system_monitor fait `float(hz)` et Gazebo prend
  # l'entier dans `<update_rate>`.
  fps: 15
  # Flux profondeur. Non exploité pour l'instant, mais publié : c'est la raison
  # d'être de ce capteur, et l'activer coûte peu.
  depth_width: 640
  depth_height: 480
  depth_fps: 15              # entier, même raison que camera.fps
  enable_depth: true
  enable_infra: false          # les deux infrarouges ne servent pas ici
  pointcloud: false            # coûteux sur un Pi 5 ; à activer au besoin
  # L'IMU du D435i (BMI055) reste COUPÉE. Le cap de l'odométrie vient du BNO055,
  # dont le biais et l'échelle sont mesurés (voir la section imu). Deux sources
  # de cap non fusionnées ne valent pas mieux qu'une seule, et brancher celle-ci
  # demanderait de la calibrer à son tour.
  enable_gyro: false
  enable_accel: false
  # Les intrinsèques viennent du capteur lui-même : le driver publie un
  # camera_info calibré en usine. Pas de fichier de calibration à maintenir,
  # contrairement à la C920 qu'il remplace.
  #
  # Simulation seulement. Ouverture horizontale du flux couleur du D435i :
  # 69 degrés selon la fiche Intel, soit 1.204 rad. À ne pas confondre avec
  # celle de la profondeur (87 degrés).
  sim_horizontal_fov: 1.204
  # Bruit gaussien de l'image simulée, en fraction de la pleine échelle. Une
  # image de synthèse parfaite donne un taux de détection de marqueurs
  # irréaliste : le détecteur ne rate jamais ce qu'aucun capteur ne rendrait
  # aussi net.
  sim_noise_stddev: 0.006
  # La PROFONDEUR n'est pas simulée : rien ne la consomme encore, et un capteur
  # `rgbd_camera` en rendu logiciel coûte cher pour une donnée que personne ne
  # lit. Le jour où elle servira, la fiche D435i donne 0.28 m de minimum et
  # 3 m de portée utile. Sur le vrai robot elle EST publiée (enable_depth).

# BNO055 en mode IMU (6 axes, magnétomètre coupé). Le Pico transmet les
# entiers bruts ; la conversion SI se fait côté Pi avec ces facteurs
# (registre UNIT_SEL = 0x00 du composant).
# BNO055 en mode IMU (fusion accéléromètre + gyromètre, magnétomètre coupé),
# lue par le Pico. Le gyromètre donne le CAP de l'odométrie (gyro_odom.py) ;
# l'accéléromètre, lui, n'est PAS utilisé : le firmware n'écrit aucun décalage
# de calibration, et le capteur lit un roulis de 7.5° et une gravité 2 % trop
# faible (mesuré le 12 sept. 2026, reproductible après redémarrage à plat).
# Le gyromètre, en revanche, est excellent : 0.005 °/s de biais, soit 0.3° de
# dérive par minute, et 0.1 °/s de bruit.
imu:
  frame: imu_link
  # ATTENTION v2 : dans le nouvel export, imu_link est RETOURNÉ de 180° autour
  # de x par rapport à la v1 — ses axes y et z pointent à l'envers. Un
  # gyromètre dont le z est inversé fait tourner le cap dans le mauvais sens,
  # et c'est le gyromètre qui porte le cap de l'odométrie. L'URDF décrit le
  # montage ; il ne change pas ce que le firmware rapporte. Vérifier le SIGNE
  # au banc (robot tourné à la main d'un quart de tour anti-horaire, le cap
  # doit croître) avant tout essai en mouvement.
  accel_lsb_per_m_s2: 100
  gyro_lsb_per_deg_s: 16
  # Correction d'échelle du cap gyroscopique. MESURÉE le 12 sept. 2026 en tours
  # complets, LiDAR pour juge (corrélation des profils de scan avant/après) :
  # le gyromètre sur-estime de 2.9 %, symétrique et répétable —
  #   2 tours à 0.6 rad/s anti-horaire : 1.0299    (roues 0.9975)
  #   3 tours à 0.9 rad/s anti-horaire : 1.0287    (roues 0.9984)
  #   2 tours à 0.6 rad/s horaire      : 1.0286    (roues 1.0061)
  # C'est l'erreur de sensibilité du BNO055, donnée à ±3 % par sa fiche. Zéro
  # trou dans le flux IMU sur ces trois essais (I2C à 100 kHz).
  gyro_scale: 0.9718

# Seuils de la supervision (system_monitor.py), en unités du Pi 5. Le SoC
# commence à se brider vers 85 °C ; 4.8 V est le seuil sous lequel le Pi 5
# signale lui-même la sous-tension ; -75 dBm est la limite où CycloneDDS en
# unicast commence à perdre des paquets sur ce WiFi.
telemetry:
  temp_warn_c: 75.0
  temp_error_c: 85.0
  rail_5v_warn_v: 4.80
  cpu_warn_percent: 85.0
  mem_warn_percent: 85.0
  disk_warn_percent: 85.0
  wifi_warn_dbm: -75.0
  rate_warn_ratio: 0.8      # cadence capteur sous 80 % de l'attendu -> WARN, nulle -> ERROR

# Contrat avec diffdrive_pico_firmware : cadence des trames S et délai du
# chien de garde. L'interface matérielle doit émettre bien plus vite que ce
# délai, y compris à l'arrêt.
pico:
  frame_rate_hz: 50
  watchdog_ms: 300
