MatthieuGrr/alidade_ros2/(commit log)

2026-09-05 Pile ROS 2 Jazzy d'Alidade : description, interface Pico, bringup, simulation, viz, systeme
    - alidade_description : export Onshape corrige au build par revision materielle
    (alidade_v1.yaml, seule source des constantes physiques), xacro pour les
    cibles real / mock / sim, controle des poses de reperes
    - alidade_hardware : SystemInterface vers diffdrive_pico_firmware (trames S a
    50 Hz, checksum, chien de garde, diagnostics, passage en erreur sur perte USB),
    banc pico_bench.py et faux Pico sur pty
    - alidade_bringup : gabarits de configuration rendus au lancement, robot.launch.py
    (slam, nav, mock), slam_toolbox lifecycle, nav2 minimal, relais TwistStamped
    - alidade_sim : Gazebo Harmonic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
    [alidade.urdf, alidade.urdf.xacro, arena.sdf, base_link.stl, battery_link.stl, battery_tray_link.stl, camera_link.stl, caster_fork_link.stl]
2026-09-05 udev : reconnaitre le Pico par le descripteur USB du firmware
2026-09-06 Fix lidar orientation and add rotation handling in URDF export script
2026-09-07 systeme : attendre la synchro NTP avant de lancer la pile
    Le Pi 5 n'a pas de pile RTC : au boot l'horloge repart de la derniere heure
    sauvegardee et NTP la recale d'un coup quelques secondes apres le lancement.
    Les noeuds deja crees restaient vivants mais disparaissaient du graphe DDS
    (plus d'odometrie ni de TF, nav2 abandonne), des que le robot etait reste
    eteint un moment. ExecStartPre attend le marqueur de systemd-timesyncd,
    60 s au plus pour ne pas bloquer un robot sans reseau.
2026-09-07 bringup : nav2 ne demarre qu'apres le premier scan
    rplidar_ros echoue au demarrage trois fois sur quatre (80008002) et le
    premier scan arrive de 15 s a plus de deux minutes apres le lancement. Sans
    scan, slam_toolbox ne publie pas le repere map, la costmap globale expire a
    l'activation (60 s) et le lifecycle manager de nav2 abandonne le bringup
    sans jamais reessayer. wait_for_scan.py sert de barriere : nav.launch.py
    s'enchaine sur sa fin, sur le robot comme en simulation.
2026-09-07 description : odometrie calibree au sol avec le LiDAR pour reference
    Rayon de roulement effectif 0.0326 m (ICP 2D des scans avant/apres une
    ligne de 0.4 m, deux sens : vrai/odom 1.016 et 1.019) et entraxe 0.1939 m
    (tours complets sur place, le profil de scan doit revenir sur lui-meme).
    Valide apres application : rotation 1.0002, translation 0.998. La
    simulation suit : disques de collision au rayon effectif, decales de
    +/-1.45 mm pour le meme entraxe efficace.
2026-09-07 controleurs : fenetre de vitesse odometrique a 10 cycles
    A 0.5 rad/s une roue avance de 7 ticks par cycle : le +/-1 tick de
    quantification faisait +/-11 % sur la vitesse publiee (0.42-0.54 rad/s pour
    0.485 de moyenne), celle que le pure pursuit utilise pour son point de
    visee. La pose n'est pas concernee.
    [controllers.yaml]
2026-09-07 README : pieges verifies sur le robot (horloge, LiDAR, IMU, angle_compensate)
2026-09-07 update motor parameters: increase max_linear_velocity to 0.40 m/s and max_angular_velocity to 2.50 rad/s
2026-09-07 camera : C920 tete en bas, image droite et reperes coherents (phase 1)
    usb_cam (MJPEG natif, mise au point fixe) publie l'image brute dans le
    repere optique physique : la CAO place ce repere comme pour une camera
    droite, camera.mount_rpy le retourne d'un demi-tour autour de l'axe optique
    par le meme mecanisme que le LiDAR (fix_urdf generalise a toute section
    frame + mount_rpy). ImageFlipNode remet l'image a l'endroit dans
    camera_upright_optical_frame, declare dans l'URDF avec la meme rotation que
    le TF que diffuse le noeud : pas de double parent. Le noeud ne corrige pas le
    point principal, la calibration se fait donc sur /camera/image.
    Regle udev sur l'index 0 seulement (l'index 1 est la me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
    [alidade.urdf.xacro, gazebo.xacro]
2026-09-07 supervision : diagnostics du Pi, cadences capteurs, agregateur, RobotState (phase 2)
    system_monitor.py publie sur /diagnostics la temperature et le throttling
    (vcgencmd), les rails du PMIC, CPU, memoire, disque, WiFi, synchro NTP, et la
    cadence de chaque topic capteur face a celle que promet la revision (la
    camera est optionnelle : absente, WARN et non ERROR). Seuils dans la section
    telemetry de alidade_v1.yaml. Les lecteurs sont des fonctions pures testees
    sans ROS ni Pi. diagnostic_aggregator regroupe en /diagnostics_agg :
    Systeme, Pico (alidade_hardware), Capteurs, Controle (ros2_control publie
    deja les siens), Navigation. Inclus sans condition par robot.launch.py et
    sim.launch.py.
    Nouve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
2026-09-08 modes : gestionnaire, cartes sauvegardees, localisation AMCL (phase 3)
    Un seul noeud decide de ce qui tourne. Tout est charge par nav:=true sans
    rien activer -- slam_toolbox (autostart:=false, sinon slam.launch.py le
    reactive dans le dos a chaque passage par inactive), map_server, amcl,
    map_saver -- et mode_manager pilote par cycle de vie : verifie en
    simulation que slam_toolbox desactive cesse bien de publier map->odom et
    /map. nav2 (lifecycle manager sans autostart) tourne si et seulement si le
    mode navigue et que map->odom existe, STARTUP la premiere fois puis RESUME
    apres une pause : sans cette regle sa costmap globale expire a l'activation
    et le bringup n'est jamais retente.
    Services a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
2026-09-08 interface : Vizanti servi par le robot, widget Alidade, profil operateur (phase 4)
    Vizanti (branche ros2, commit epingle) est clone a cote d'alidade_ros2 par
    system/sources.sh -- appele par install.sh sur le Pi et par run.sh up dans
    le conteneur -- et lance par ui.launch.py avec le profil
    alidade_ui/config/operator.json : widget Alidade, carte, scan, TF, pose
    initiale, but, joystick sur /cmd_vel_smoothed (jamais /cmd_vel), camera,
    diagnostics. Web sur 5000, rosbridge sur 5001.
    Le widget Alidade (alidade_ui/templates/alidade) affiche /robot/state et
    commande les modes, la carte et la sauvegarde par les services du
    gestionnaire. sources.sh le lie fichier par fichier dans le dossier public de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
2026-09-08 exploration : frontieres, sauvegarde automatique et retour au depart (phase 5)
    Mode EXPLORATION = cartographie plus frontier_exploration_ros2 (commit
    epingle par system/sources.sh, regle pour un robot de 15 cm de rayon dans
    une piece de 6 m avec un LiDAR de 12 m : distances minimales a 2.5 rayons,
    tassement apres chaque frontiere, suppression des frontieres qui echouent).
    L'explorateur est lance inactif ; le gestionnaire le demarre et l'arrete par
    /control_exploration -- toujours avant de quitter le mode, il tient un but
    nav2 -- et ecoute /exploration_complete : plus de frontiere, carte
    sauvegardee sous exploration_<date>, retour au point de depart par
    l'explorateur, puis MAPPING. Un vieux m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
2026-09-08 camera et supervision : corrections tirees du premier passage sur le robot
    Le noeud de retournement republiait sa sortie sur sa propre entree :
    image_transport resout le nom de base avant de creer ses publications, si
    bien qu'un remappage s'applique deux fois, et mes regles se repondaient.
    /camera/image restait vide, la boucle coutait un demi-coeur (conteneur
    camera de 61 a 13 % apres correction) et sa gigue faisait passer l'ecart-type
    de periodicite du controller_manager de 2 a 13 Hz. Les deux noeuds vivent
    desormais dans /camera/raw, ou les noms par defaut tombent juste, avec une
    seule regle chacun. Verifie image a l'appui : la brute est bien a l'envers,
    la sortie a l'endroit, camera_info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
    [controllers.yaml]
2026-09-08 teleop protege, degagement possible, et TELEOP ne detruit plus la carte
    Trois defauts remontes du terrain, lies.
    Le joystick ne faisait rien sur /cmd_vel_smoothed : TELEOP mettait tout nav2
    en pause, moniteur de collision compris, si bien que personne n'ecoutait. La
    chaine de securite (lissage et moniteur) forme desormais son propre groupe de
    cycle de vie, demarre avec la pile et jamais mis en pause -- elle ne depend
    que de l'odometrie et du scan. Seule la planification reste pilotee par le
    gestionnaire de modes. Le joystick publie sur /cmd_vel_nav et passe donc par
    toute la chaine, lissage compris ; publier sur /cmd_vel court-circuitait le
    moniteur, donc roulait sans garde-fou.
    Le moniteu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
2026-09-08 interface : repere fixe 'map', sinon AMCL rejette la pose initiale
    Les widgets de pose initiale et de but publient dans tf.fixed_frame. Mon
    profil operateur le fixait a 'odom' : AMCL refusait la pose (« initial poses
    must be in the global frame ») et la carte, publiee dans 'map', ne pouvait
    pas etre dessinee faute de transformation map->odom. Cercle vicieux, verifie
    sur le robot : pose dans odom -> AMCL reste muet, meme pose dans map ->
    localise et publie map->odom dans la seconde. En cartographie le defaut ne se
    voyait pas, slam_toolbox publiant map->odom des le premier scan.
    L'echelle de qualite de localisation passe a un metre : une pose posee a la
    main vaut deja 0.7 m d'incertitude et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
2026-09-08 odometrie a l'origine, et amcl repart propre a chaque localisation
    Le Pico compte les ticks depuis SON demarrage : sans origine prise a
    l'activation, les positions de roue valaient +1574 et +1722 rad des la
    premiere lecture et diff_drive_controller demarrait son odometrie a
    (-0.72, +0.12, -19.5 deg) au lieu de zero. PicoSystem::on_activate memorise
    desormais les compteurs comme reference, la difference etant calculee en 32
    bits signes pour rester juste en cas de debordement. Verifie sur le robot :
    roues et odometrie a 0.000 apres redemarrage.
    amcl garde son filtre d'une desactivation a l'autre et republie aussitot la
    pose de la session precedente, eventuellement issue d'une AUTRE carte : le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
2026-09-09 aruco : detection des marqueurs du cube, composee avec la camera (phase 6)
    Premiere brique du docking : reperer le cube de 50 mm dont chaque face porte
    un marqueur 4x4 de 40 mm numerote de 1 a 6. Detection seulement -- la pose du
    CUBE viendra ensuite, et les poses par marqueur ne vaudront que ce que vaudra
    la calibration, encore nominale.
    aruco_opencv est compose dans le conteneur de la camera plutot que lance a
    part : une image 640x480 en rgb8 pese 900 ko, soit 13.8 Mo/s a 15 Hz qu'il
    serait absurde de serialiser entre deux processus de la meme machine. Le
    conteneur passe en multi-thread, sinon la detection retarderait l'acquisition.
    La souscription est en reliable et jamais en best_effort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
2026-09-09 aruco : geometrie du cube, verifiee par rendu et par test
    L'utilisateur a donne la disposition des six faces. Elle est figee dans
    config/cube.yaml, decrite par deux vecteurs unitaires par face -- normale
    sortante et direction du haut du motif, soit exactement les axes z et y du
    repere marqueur d'OpenCV -- plutot que par des matrices de rotation : cela se
    relit sur le cube pose devant soi, et une erreur de signe s'y voit. Repere du
    cube en convention ROS, origine au centre, x vers l'avant (face 2), y vers la
    gauche (face 5), z vers le haut (face 1).
    Deux garde-fous, parce qu'une faute de signe serait invisible et fausserait
    tout l'accostage. test_cube.py verifie que chaque face definit un re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
2026-09-09 aruco : mise a l'epreuve sur le robot, et controle d'aplomb de la camera
    Premiere detection du vrai cube. Trois enseignements du terrain, tous
    documentes.
    Le support de camera doit etre d'aplomb, et l'URDF le suppose sans que rien
    ne le verifie : une inclinaison ne se voit pas a l'image, elle se traduit par
    une erreur de hauteur sur tout ce qu'on detecte. Le cube pose au sol donnait
    62 mm la ou sa demi-arete en vaut 25 ; redresse, 21 mm. Un millimetre
    d'erreur a 43 cm vaut 0.13 degre de devers : la mesure est bien plus sensible
    que l'oeil, d'ou la procedure ajoutee au README.
    La pose d'un marqueur plan seul est ambigue. Cube immobile a 43 cm : distance
    stable a +/-1.3 mm, mais orientation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
2026-09-09 camera : generateur de la mire de calibration
    Damier 9x7 cases de 25 mm, soit 8x6 coins interieurs, centre sur une A4
    paysage. Damier classique et non ChArUco a dessein : une mire ChArUco porte
    des marqueurs 4x4 que le detecteur du cube prendrait pour ses propres faces.
    Le PDF est ecrit a la main plutot que par une bibliotheque : la cote imprimee
    fixe l'echelle de toutes les mesures ensuite, on ne veut aucune transformation
    intermediaire. Deux traits encadrent le damier pour verifier au reglet que
    l'impression n'a pas ete mise a l'echelle -- 9 cases doivent faire 225.0 mm.
    Verifie par rendu a 300 dpi : page 297.0 x 210.1 mm, damier 225.04 mm de
    large, et OpenCV y retrouve 48 coins en 8x6 a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
2026-09-11 description : nouveaux supports de camera et de LiDAR, export Onshape allege
    Nouvel export de la CAO. Le LiDAR est abaisse de 26 mm et recule de 25 mm,
    son support et celui de l'IMU sont fondus dans le plateau ; la camera, sur
    un nouveau support, plonge de 25 degres. Les poses attendues de la revision
    suivent, et fix_urdf les retrouve a 0.13 mm pres. Aucune piece ne coupe le
    plan du LiDAR : la plus haute apres lui culmine a 130 mm, contre 153.7 mm
    pour son repere.
    Maillages exportes en resolution grossiere : 16 Mo au lieu des 116 Mo d'un
    export fin. Le README note la marche a suivre apres un export, qui vide le
    dossier urdf/.
    [alidade.urdf, base_link.stl, battery_link.stl, camera_link.stl, camera_mount_link.stl, caster_fork_link.stl, caster_mount_link.stl, caster_wheel_link.stl]
2026-09-11 camera : montee a l'endroit, sans noeud de retournement
    La C920 est maintenant a l'endroit : le repere optique de la CAO la decrit
    telle quelle. Disparaissent mount_rpy, ImageFlipNode, le repere
    camera_upright_optical_frame et la dependance a image_rotate. usb_cam publie
    directement /camera/image et /camera/camera_info, par une seule regle de
    remappage : les consommateurs (interface, ArUco, simulation) ne changent pas
    de topic, la supervision suit le camera_info.
    La camera simulee etait placee par une pose recopiee a la main, perimee
    avec le nouveau support. Elle est accrochee au repere optique, avec la seule
    rotation de convention entre Gazebo et le repere optique : apres conversion
    SDF, e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
    [alidade.urdf.xacro, gazebo.xacro]
2026-09-11 camera : noms de topics natifs du pilote, sans remappage
    Le remappage image_raw -> image ne s'appliquait qu'au topic de base :
    image_transport cree les topics de ses plugins sous le nom NON remappe, si
    bien que le JPEG partait sur /camera/image_raw/compressed pendant que
    l'interface ecoutait /camera/image/compressed. Constate sur le robot : plus
    d'image dans Vizanti.
    Plus aucun remappage : le pilote publie /camera/image_raw (+ /compressed) et
    /camera/camera_info, et l'interface, ArUco, la simulation, le banc et la
    commande de calibration suivent.
    [gazebo.xacro]
2026-09-11 camera : le controle d'aplomb suppose la camera calibree
    Camera inclinee, une erreur de focale se reporte sur la hauteur mesuree :
    72 mm avec la focale nominale sur le support a 25 degres, 36 mm en
    recalculant avec la focale mesuree, pour 25 attendus.
2026-09-11 camera : autofocus enfin coupe, commandes V4L2 sous leurs noms actuels
    usb_cam 0.8 regle la camera sous des noms de commandes que les noyaux 6.x
    ont renommes : « unknown control 'focus_auto' », puis « Permission denied »
    sur focus_absolute. La C920 est donc restee en autofocus depuis le debut,
    et autofocus: false n'avait jamais ete applique.
    camera.launch.py pose lui-meme, sous les noms actuels, l'autofocus, la mise
    au point et l'anti-scintillement (50 Hz en France, 60 Hz d'usine) avant de
    demarrer le pilote. La luminosite revient a 128, le defaut de la camera ;
    celui d'usb_cam, 50, assombrissait l'image. Verifie sur le robot :
    focus_automatic_continuous 0, focus_absolute a la valeur de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
2026-09-11 camera : mise au point reglee et calibration a la mire
    Mise au point fixee a 30 par balayage de la nettete de la mire : optimum 35
    a 30 cm, 25 a 51 cm, et 30 garde plus de 83 % de l'optimum aux deux
    distances. La focale varie de 8 % sur la course de mise au point, d'ou une
    calibration liee a cette valeur.
    Calibration camera_calibration, damier 8x6 de 25 mm : 45 vues de 29 a
    66 cm, 0.32 px de reprojection, deux demi-echantillons d'accord a 0.4 %
    sur la focale. fx = 644.5 px, contre 530 nominaux et les 690 estimes
    auparavant en autofocus. L'ouverture simulee suit (0.922 rad), et le cube
    reste visible de 11 a ~70 cm devant le chassis au lieu de 55.
    camera_bench.py rend la procedure reproducti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
2026-09-11 camera : inclinaison mesuree, 28.2 degres au lieu des 25 de la CAO
    Camera calibree, cube au sol a 30 cm de la face avant du robot : les deux
    marqueurs vus sortaient 18 mm trop haut (42.5 au lieu de 25 mm, 68.9 au lieu
    de 50). Une seule rotation de 3.2 degres remet les deux hauteurs et la
    distance (424 mm pour ~420). mount_rpy l'ajoute dans le repere optique ;
    fix_urdf la compose sans toucher aux positions, et la camera simulee suit.
    Plage de visibilite recalculee avec cet angle et la vraie face avant du
    robot (x = 120 mm, et non 104) : cube entier de 8 a 42 cm, l'approche se
    travaillant a 30 cm. L'origine de l'ecart, support ou assiette du chassis,
    reste a etablir.
2026-09-11 aruco : pose du cube depuis ses faces, affichee dans Vizanti
    cube_detector.py convertit les detections ArUco en pose du cube : chaque
    face vue la donne a elle seule par la geometrie de cube.yaml, plusieurs
    faces sont moyennees, et leur desaccord en position comme en orientation
    est mesure. Il publie /cube/pose et /cube/markers (cube, fleche vers la face
    « devant », etiquette des faces vues) ; Vizanti a un widget MarkerArray
    preregle. Les identifiants etrangers au cube sont ignores.
    Sur le robot, cube a 30 cm : centre a x 449.7, z 25.8 mm (450 et 25
    attendus), faces 1 et 4 d'accord a 1 mm. Mais pas en orientation, a 92
    degres pres : le motif du dessus a son haut vers la gauche, pas vers
    l'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
2026-09-11 docking : approche du cube jusqu'a 10 cm d'une face (mode DOCKING)
    cube_detector.py publie /cube/dock_pose : ou base_footprint doit s'arreter,
    face au cote vertical du cube le plus tourne vers le robot, avec hysteresis
    pour ne pas changer de face en pleine approche. cube_docking.py sert les
    actions /dock_robot et /undock_robot (types nav2_msgs) : mise en place a
    l'odometrie dans l'axe de la face (pivot, ligne droite, pivot, recul si le
    cube est trop pres), puis approche asservie sur la vision jusqu'a la ligne
    d'arret, controle de l'arrivee et reprise si elle est hors tolerance. Les
    detections sont ramenees dans odom a l'instant de l'image, par un
    historique de l'odometrie.
    Le serveur de doc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
2026-09-11 docking : reglages mesures sur le robot, cible filtree, simulation isolee
    Essais reels, tous reussis du premier coup : depart dans l'axe, 1 mm et
    1.1 degre en 2.9 s ; a 9 degres et 3.4 cm, 2 mm et 1.0 degre en 3.0 s ;
    decale de 7.7 cm (mise en place), 8 mm et 4.2 degres en 8.5 s. Face du cube
    a 10.4-10.6 cm de la face avant a l'arret (camera).
    Ce que le robot a appris, et qui est corrige :
    - les moteurs ne tiennent pas les basses vitesses (0.25 rad/s donne 0.08,
    2 cm/s donne 0.6, demarrage dissymetrique) : planchers a 0.45 rad/s et
    5 cm/s, et les tests cinematiques simulent desormais cette zone morte ;
    - usb_cam date ses images ~0.5 s trop tot (790 ms apparents pour 300 ms
    reels, mesu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
2026-09-12 systeme : la pile repart quand le Pico ou le LiDAR revient
    BindsTo arrete la pile des qu'un des deux appareils disparait -- la securite
    voulue, les moteurs se coupent -- mais cet arret est PROPRE : Restart=on-failure
    ne relancait rien et la pile restait muette jusqu'a un systemctl restart.
    Constate le 12 sept. 2026 : coupure/remise du Pico, 20 minutes de robot mort.
    WantedBy porte desormais aussi sur dev-pico.device et dev-rplidar.device : le
    branchement fait repartir le service. install.sh passe a reenable pour recreer
    les liens .wants correspondants.
2026-09-12 odometrie : le cap vient du gyromètre, la distance des roues
    gyro_odom.py publie /odom et le repere odom -> base_footprint ;
    diff_drive_controller ne publie plus ce repere (enable_odom_tf: false) mais
    garde son odometrie roues, qui sert de temoin. Le calcul est dans
    alidade_bringup/odometry.py, teste sans ROS (trajets connus, patinage, perte
    d'IMU, biais, echelle).
    Pourquoi le gyromètre, mesure a l'appui sur le robot : biais 0.005 deg/s, soit
    0.3 deg de derive par minute, et 0.1 deg/s de bruit ; les roues se trompent de
    1 a 2 % par rotation et ne voient pas un patinage. L'accelerometre reste
    INUTILISE : le firmware du Pico n'ecrit aucun decalage de calibration, et le
    capteur lit 7.5 deg d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
    [controllers.yaml]
2026-09-12 odometrie : echelle du gyromètre mesuree, 0.9718
    Tours complets sur le robot, LiDAR pour juge : le gyromètre sur-estime de
    2.9 %, symetrique (1.0299 et 1.0287 en anti-horaire, 1.0286 en horaire) et
    repetable a 0.1 %. C'est son erreur de sensibilite, donnee a +-3 % par la
    fiche du BNO055. Les roues, elles, tiennent leur calibration (0.9975 a
    1.0061). Aucun trou dans le flux IMU sur les trois essais.
2026-09-12 odometrie : outil de calibration dans le depot, et documentation
    odom_calib.py rassemble les deux mesures qui avaient ete perdues avec leur
    session : rotate (N tours complets, correlation circulaire des profils de
    scan) et straight (ligne droite, ICP 2D point a point initialise par
    l'odometrie). Trois sources comparees a chaque essai : roues, gyromètre et
    /odom fusionne. Le LiDAR contre la scene reste le seul juge -- ni l'IMU ni
    slam_toolbox ne peuvent l'etre.
    Le README decrit l'odometrie a cap gyroscopique, sa calibration, et trois
    pieges mesures : l'accelerometre non calibre (gravite 9.606 au lieu de 9.807,
    roulis apparent 7.5 deg pour 1 deg au niveau), la trame de zeros qu'envoie le
    fir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
2026-09-13 description : support camera a 20 degres
    Nouvel export Onshape : le support passe de 25 a 20 degres (0.436 -> 0.349
    rad), seul le repere optique bouge (2.1 mm, pivot autour du support). La
    correction de -3.2 degres mesuree au cube valait pour l'ancien support ; elle
    est retiree, l'inclinaison reelle du nouveau reste a mesurer.
    [alidade.urdf, camera_mount_link.stl]
2026-09-13 camera : inclinaison mesuree du support a 20 degres, 23.5
    Cube a 31 cm, camera calibree : marqueurs 20 mm trop hauts avec 20 degres
    (44.3 et 70.5 mm pour 25 et 50). Une rotation de 3.52 degres remet les deux
    hauteurs, a 0.07 degre pres l'une de l'autre. L'ancien support mesurait deja
    3.2 degres de plus que sa CAO : ecart commun, pas propre au support.
2026-09-13 docking : arret a 5 cm, fin d'approche a l'odometrie
    A 5 cm, seul le dessus du cube est encore dans l'image, et le bas de l'image
    le coupe dans le dernier centimetre. Mesure sur le robot, camera a 23.5 deg,
    par pas de 5 mm : la face tournee vers le robot disparait entre 11 et 7.5 cm
    d'ecart, le dessus entre 5.5 et 4 cm.
    L'approche ne s'arrete donc plus sur un cube perdu de vue a moins de 4 cm de
    la ligne d'arret (blind_distance) : elle finit a l'odometrie sur la derniere
    cible connue, que le cube immobile et le cap du gyromètre rendent fiable. Plus
    loin, un cube perdu reste un echec, avec reprise. En simulation : arrivee a
    3 mm et 0.1 deg en 8 s.
2026-09-13 aruco : pose du cube tiree des positions des marqueurs, plus des orientations
    De loin, un marqueur de 20 px a deux orientations presque aussi probables, et
    aruco_opencv choisit la mauvaise la plupart du temps : mesure sur le robot,
    cube vu en coin a 70 cm, 80 % des images. Les faces se contredisaient (cube
    rouge 114 fois sur 150) et la face visee basculait, la pose d'arret sautant de
    -48 a +45 deg. Leurs POSITIONS, elles, restent justes au millimetre : le cap
    tire du segment entre les centres des faces 2 et 5 donnait +142 deg, le mode
    minoritaire de chacune.
    cube.estimate_on_floor calcule donc la pose dans le repere du robot, ou le sol
    est connu : deux faces verticales voisines donnent leur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
2026-09-13 aruco : une face vue seule ne donne une pose que de pres
    Sur le cube vu en coin a un metre, la geometrie tranchait 122 images sur 138,
    mais les 16 images a une seule face envoyaient un cap faux de +-50 deg : la
    face visee basculait entre les deux faces a egalite, la pose d'arret sautant
    de -52 a +52 deg. Au-dela de 45 cm de la camera, une face seule ne donne donc
    plus de pose ; deux faces restent exploitables a toute distance.
2026-09-13 aruco : hysteresis de la face visee a 30 deg
    Cube vu pile en coin a un metre, toutes les poses tirees de la geometrie : le
    cap tremble de +-10 deg (profondeur des marqueurs a +-2 a 6 mm sur 33 mm
    d'ecart), assez pour franchir 15 deg entre deux faces a egalite.
2026-09-13 doc : ambiguite des marqueurs vus de loin, et la reponse par la geometrie
2026-09-13 doc : camera a 20 degres (23.5 mesures), docking a 5 cm
2026-09-13 docking : mise en place refaite si la cible a change, latence reglable a chaud
    Parti de loin, le docking visait une pose estimee a un metre, et le cube, hors
    du champ pendant les pivots, reapparaissait parfois sous une autre face :
    l'approche visait alors une cible a 17 cm et 58 deg (mesure : deux reprises,
    32 s). La mise en place est desormais refaite, jusqu'a deux fois, tant que
    la cible vue a son arrivee la rend necessaire.
    detection_latency et blind_distance se reglent a chaud, pour les campagnes
    d'essais.
2026-09-13 docking : latence calibree sur l'ecart reel, campagne d'essais dans le depot
    Trois campagnes sur le robot, l'ecart final reel mesure en reculant d'une
    distance connue jusqu'a 30 cm, ou la camera est juste :
    detection_latency 0.35 s -> 6.0 / 6.0 / 6.1 cm
    detection_latency 0.0 s -> 4.3 / 4.2 / 4.2 cm
    detection_latency 0.15 s -> 5.1 / 5.1 / 4.9 cm (vise 5.0)
    Relation lineaire, 5 mm par 0.1 s a la vitesse de fin d'approche : 0.15 s est
    une constante calibree, qui absorbe aussi le retard de l'odometrie et le biais
    de la camera de pres. 7 dockings sur 7 reussis depuis ~30 cm, 6 du premier
    coup, 4 a 6 s, lateral 0 a 5 mm.
    Au-dela de 45 cm, seul un cube vu en coin, deux faces nettes, donne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
2026-09-28 docking generique, simulation reglable, revisions verifiees
    Ce que retient main d'un detour par la Coupe de France, abandonnee. Le
    travail qui s'y rapportait vit sur la branche coupe-2027 et n'est pas
    repris ici ; seul reste ce qui ne parlait pas de pierres.
    DOCKING. docking.py ne sait plus ce qu'il aborde : une pose d'arret, un
    centre, une odometrie. Reconnaitre la cible est le travail du detecteur,
    et en changer ne demande plus d'y toucher. cube_docking.py devient donc
    docking_server.py -- volontairement homonyme de celui de nav2, dont il
    sert les memes actions.
    SIMULATION. Le point d'apparition se choisit (spawn_x, spawn_y,
    spawn_yaw) au lieu d'imposer l'origine du monde. La detection A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
    [arena.sdf, gazebo.xacro]
2026-09-28 revision v2 : chassis redessine, RealSense D435i, IMU par TF
    Le robot a ete entierement refait. La v1 decrivait une machine qui n'existe
    plus : elle est supprimee, pas archivee. Un seul commit parce que les quatre
    volets ci-dessous sont indissociables -- separer le zero de lidar.mount_rpy du
    flip_x_axis qui le compense produirait un etat intermediaire faux.
    GEOMETRIE. Plateau 158x156 -> 250x252 mm, roues O64 -> O99.6, entraxe 191 ->
    225 (CAO), roulette O22 a l'avant -> O50 a l'arriere, LiDAR recule de 146 mm et
    monte de 11. Moteurs, reducteur, encodeurs, Pi, batterie, LiDAR et IMU sont les
    MEMES pieces : volumes d'export identiques au centieme, leurs mesures sont
    reprises sans reserve.
    L'a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
    [alidade.urdf.xacro, alidade_v2.urdf, base_link.stl, battery_link.stl, battery_tray_link.stl, camera_link.stl, camera_mount_link.stl, caster_fork_link.stl]
2026-09-29 odometrie calibree au sol, et odom_calib ne roule plus aveugle
    CALIBRATION (29 sept. 2026, LiDAR pour juge, ni SLAM ni IMU) :
    rayon 50.0 mm CAO -> 49.7 mm de roulement (-0.66 %)
    entraxe 225.0 mm CAO -> 228.9 mm efficace (+1.74 %)
    Rayon : deux lignes droites d'un metre, ICP 2D avec 326 et 329 appariements,
    +0.55 % et +0.77 %. La cote CAO du disque etant 49.8 mm, le pneu charge roule
    0.3 % plus petit : l'ecrasement attendu.
    Entraxe : deux tours complets dans CHAQUE sens, profils de scan correles.
    L'odometrie sur-estimait de 1.0241 et 1.0242 -- identiques a 0.01 %, sans le
    biais unilateral qu'avait la v1. Apres correction : 1.0024 et 1.0008 sur les
    roues, 1.0011 et 0.9997 s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
    [alidade_v2.yaml]
2026-10-06 LiDAR sur l'UART du Pi, et la cause des « Cannot start scan » enfin mesuree
    Le C1 a desormais son alimentation propre et parle directement a l'UART du Pi,
    sans adaptateur USB. La configuration suit ; le capteur, lui, NE DEMARRE
    TOUJOURS PAS de facon fiable, et le correctif reste a faire.
    CONFIGURATION
    - la regle udev lie /dev/ttyAMA0 a /dev/rplidar, donc rplidar.yaml et
    alidade.service n'ont pas a connaitre le cablage ;
    - lidar_reset.py reveille le capteur, appele en ExecStartPre ;
    - deux prerequis cote Pi, hors depot et documentes dans la regle udev :
    retirer `console=serial0,115200` de /boot/firmware/cmdline.txt et
    `systemctl disable --now serial-getty@ttyAMA0`. Une co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
2026-10-06 le C1 demarre : le pilote ne connaissait pas le capteur
    Un mois de « Cannot start scan: 80008002 », 18 a 38 echecs et jusqu'a
    7 minutes avant qu'un scan sorte. Ont ete soupconnes puis mis hors de cause
    le support mecanique, le hub USB, l'alimentation (une alimentation dediee a
    ete achetee), le cable, puis le passage en UART direct. Rien de tout cela.
    ros-jazzy-rplidar-ros annonce lui-meme son perimetre : « support rplidar
    A2/A1 and A3/S1 ». Le C1 n'y figure pas. Il embarque la SDK 1.12.0, dont
    l'API depreciee ne demande pas au capteur ce qu'il sait faire : elle compare
    son firmware a un seuil fixe pour la serie A (>= ((0x1<<8) | 17), soit 1.17).
    Le C1 annonce 1.02, donc 258 < 273, verdi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
    [alidade_v2.yaml]
2026-10-07 rectification : c'est le binaire publie qui ignore le C1, pas rplidar_ros
    Le commit 286f219 affirmait que « ros-jazzy-rplidar-ros ne connait pas le C1 »
    et s'appuyait sur la description du paquet. Les deux points sont faux ou sans
    valeur, et l'explication laissait croire qu'il faut fuir ce depot.
    La branche ros2 de rplidar_ros LISTE le C1 et fournit un
    view_rplidar_c1_launch.py. Mais ce support vit dans « Forthcoming » : jamais
    publie. Derniere release 2.1.4 (aout 2023) ; Jazzy en livre 2.1.0 (septembre
    2022), anterieure au capteur lui-meme. Le vrai critere est donc PUBLIE contre
    COMPILE DEPUIS LES SOURCES, pas un depot contre l'autre -- batir cette
    branche-la aurait marche aussi bien q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
2026-10-07 calibration du 7 octobre : rien a changer, et le gyrometre passe par TF
    Campagne complete apres le changement de pilote LiDAR. Trois rotations de deux
    tours (deux anti-horaire, une horaire) et une ligne droite de 1 m a 0.15 m/s
    avec 330 appariements ICP.
    roues en rotation 1.0026 / 1.0036 / 1.0016
    gyrometre 1.0285 / 1.0285 / 1.0331
    fusion /odom 0.9997 / 0.9992 / 1.0045
    ligne droite distance roues +0.12 %, cap +0.66 deg (fusion +0.58)
    Aucune valeur de la revision ne bouge, et c'est le resultat : le biais des
    roues en rotation, +0.26 %, est du MEME ORDRE que la resolution du juge, dont
    le residu est quantifie au degre et s'etale sur +/-1.5 deg de 720 (+/-0.2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
2026-10-08 la camera existe : pilote installe, profils valides, montage mesure
    Premier branchement du D435i, et trois choses sortent.
    LE PILOTE N'ETAIT PAS INSTALLE. ros-jazzy-realsense2-camera manquait sur le
    robot -- system/install.sh n'avait pas ete rejoue depuis son ajout a
    apt-packages.txt. Le conteneur echouait sur « Could not find requested resource
    in ament index », et comme camera.launch.py saute le conteneur quand aucune
    camera n'est branchee, l'erreur etait invisible. Rien a changer dans le depot :
    le paquet y etait deja declare.
    LES PROFILS ETAIENT REFUSES EN SILENCE. camera.fps valait 15.0, la chaine
    rendue valait « 640x480x15.0 », et le pilote exige un entier : il se rabattait
    sur 1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
    [alidade_v2.urdf, camera_adaptor.stl]
2026-10-08 piege : apt-packages.txt n'installe rien sans rejouer install.sh
    Le symptome ne designe pas la cause : un paquet declare mais absent fait
    echouer le chargement du composant sur « Could not find requested resource in
    ament index », qui parle du nom du composant. Et camera.launch.py saute son
    conteneur quand aucune camera n'est branchee, donc l'erreur peut rester
    invisible des semaines. Avec la commande qui liste les manquants d'un coup.
2026-10-08 la vue camera de Vizanti : un flux compresse, et le bon nom de topic
    Vizanti SAIT afficher une camera -- il fournit un widget compressedimage, deja
    present dans la disposition par defaut d'alidade_ui. Mais il ne pouvait rien
    montrer, pour deux raisons cumulees.
    Le widget ecoutait /camera/image_raw/compressed, nom herite de la C920 sous
    usb_cam. La RealSense publie sous /camera/color/image_raw. Topic corrige dans
    alidade_ui/config/operator.json. Verifie avant correctif : 0 publieur, et deux
    abonnements de vizanti_rosbridge dans le vide.
    Et AUCUN flux compresse n'existait, ni pour la couleur ni pour le debug ArUco,
    les deux noeuds concernes tournant en intra-processus. Or rosbridge ne
    transp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
